scottmsilver/treddy/hardware/Esp32Tap/firmware/esp32_rs/partitions_esp32tap.csv

# Name | Type | SubType | Offset | Size | Flags
nvs | data | nvs | 0x9000 | 0x6000
phy_init | data | phy | 0xf000 | 0x1000
factory | app | factory | 0x10000 | 0x200000
storage | data | littlefs | 0x210000 | 0x100000
