scottmsilver/treddy/hardware/Esp32Tap/enclosure/esp32tap_lid.stl

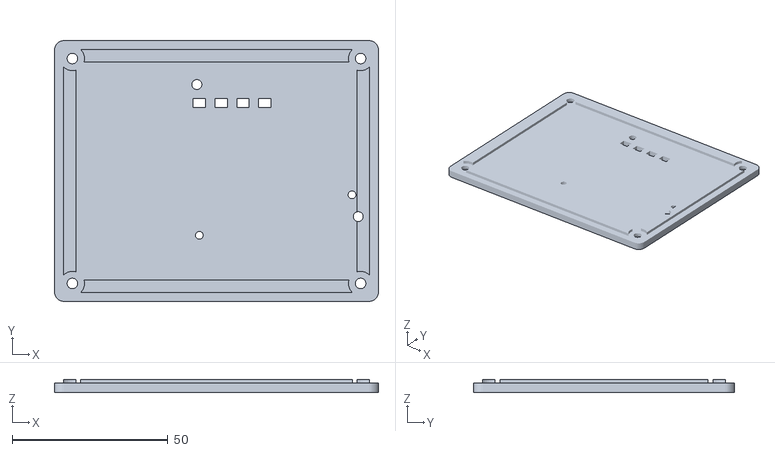
[picture p3: CAD file, 2026-11-12]
hardware/Esp32Tap/enclosure/esp32tap_lid.stl
104.0 x 83.7 x 4.20
