scottmsilver/treddy/hardware/Esp32Tap/enclosure/esp32tap_base.stl

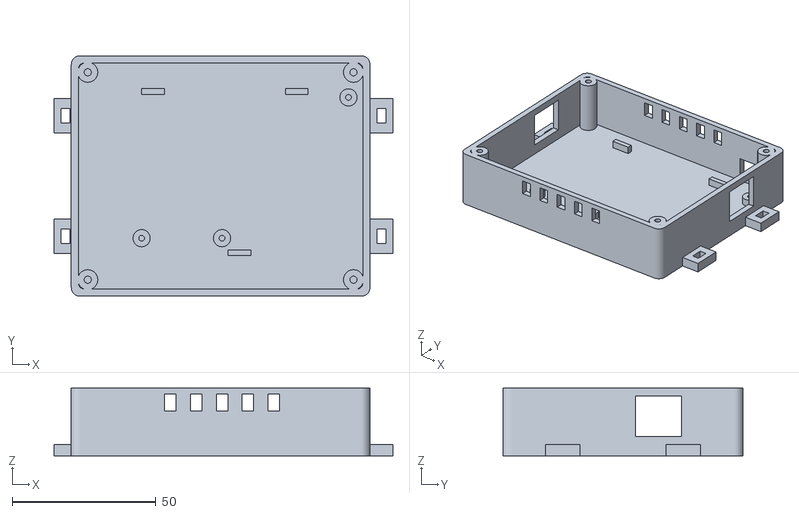
[picture p4: CAD file, 2026-11-12]
hardware/Esp32Tap/enclosure/esp32tap_base.stl
118.0 x 83.7 x 23.6
