scottmsilver/treddy/hardware/Esp32Tap/kicad/Esp32Tap.kicad_pcb

## KiCad design hardware/Esp32Tap/kicad/Esp32Tap.kicad_pcb (2026-11-12)

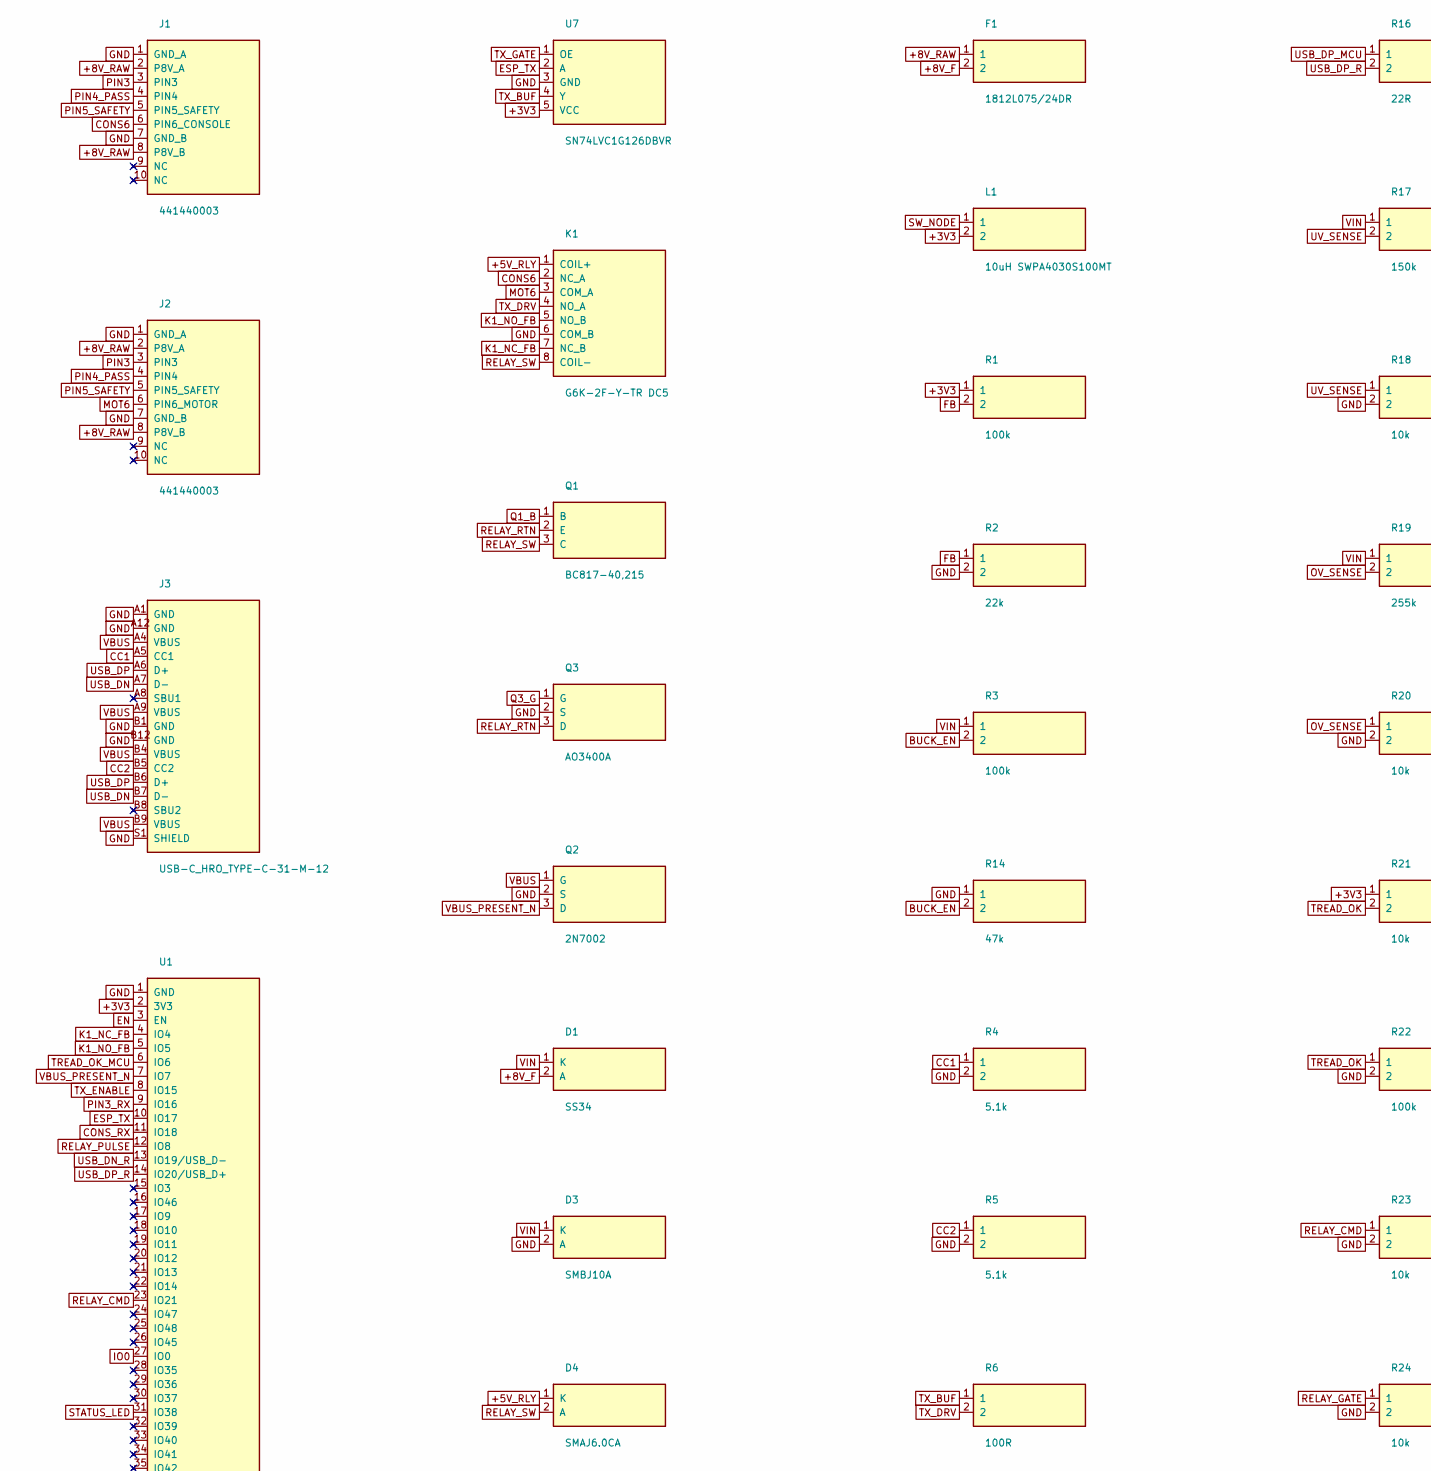
[picture p5: schematic Esp32Tap.kicad_sch, Esp32Tap Rev E - ESP32-S3 Precor serial-bus tap, part in row 1, column 1]

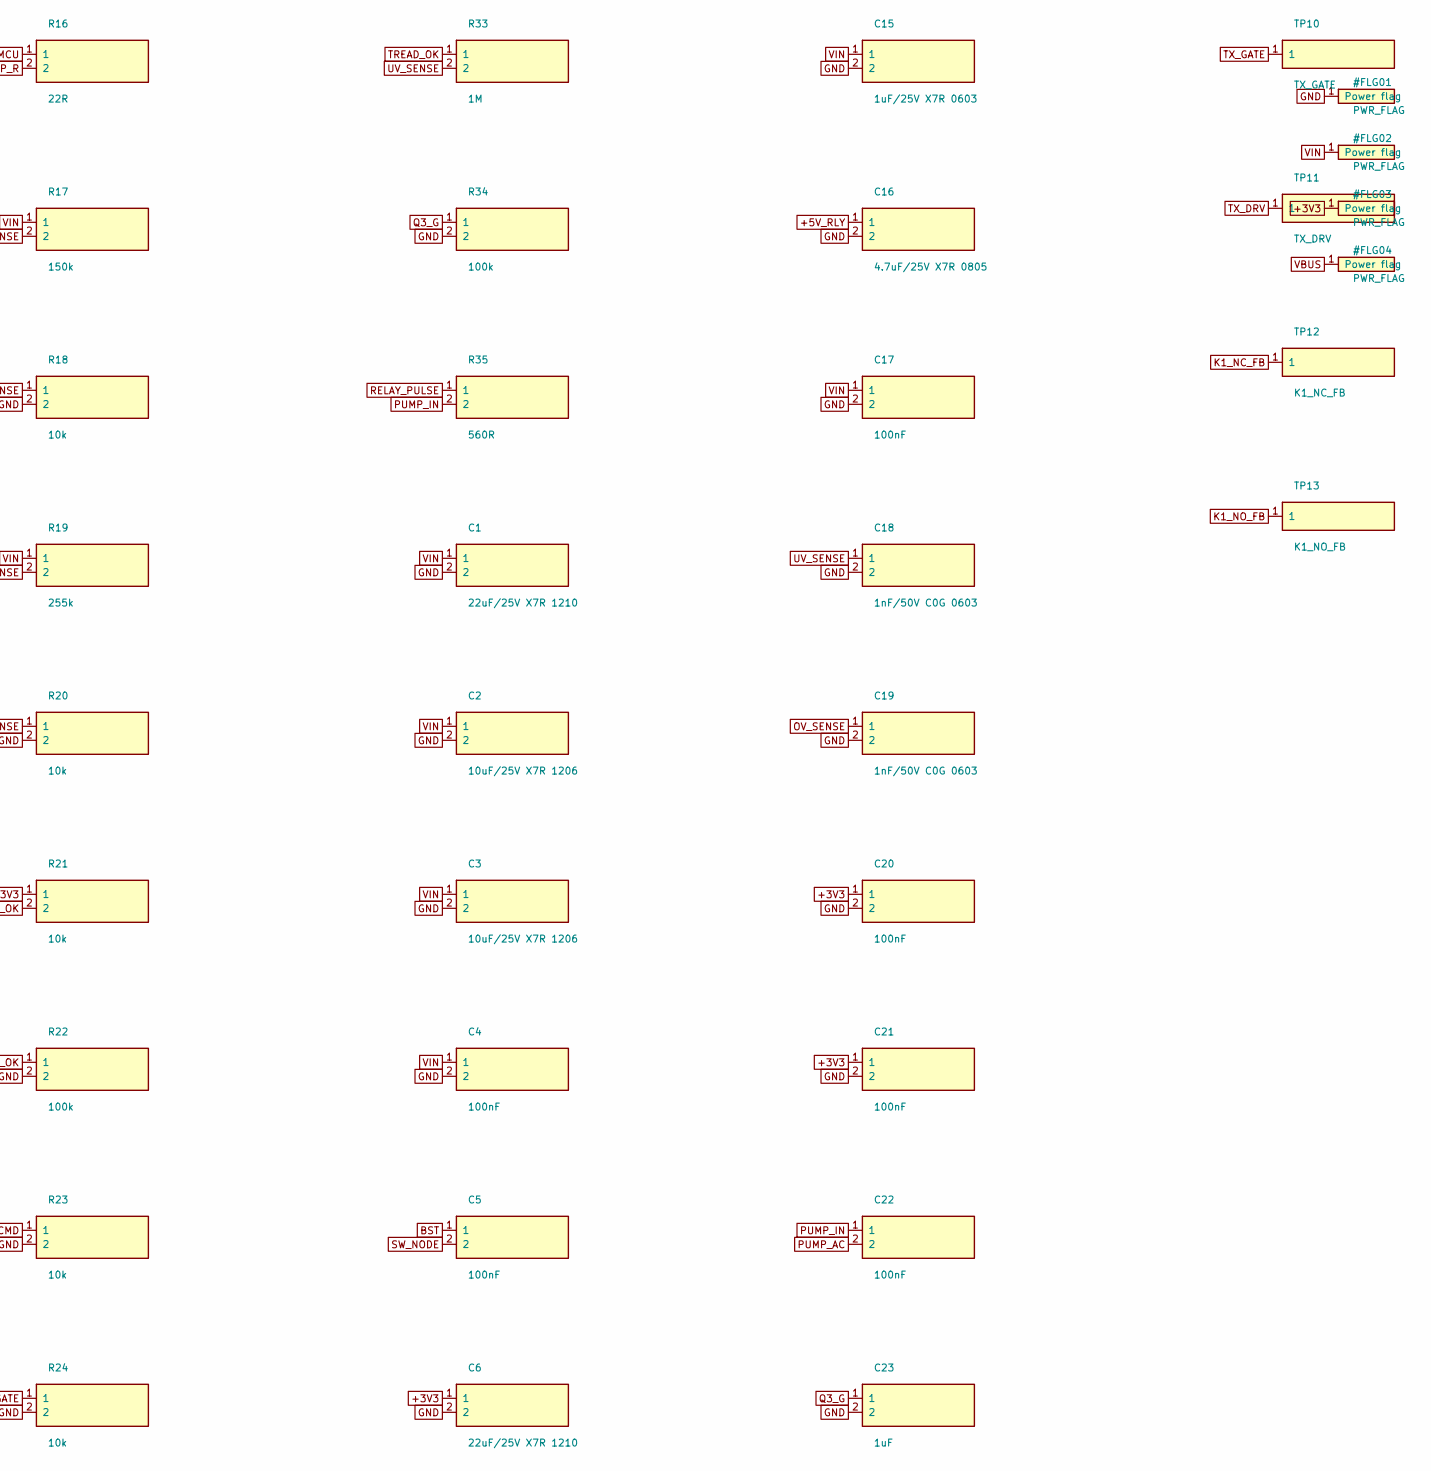
[picture p6: schematic Esp32Tap.kicad_sch, Esp32Tap Rev E - ESP32-S3 Precor serial-bus tap, part in row 1, column 2]

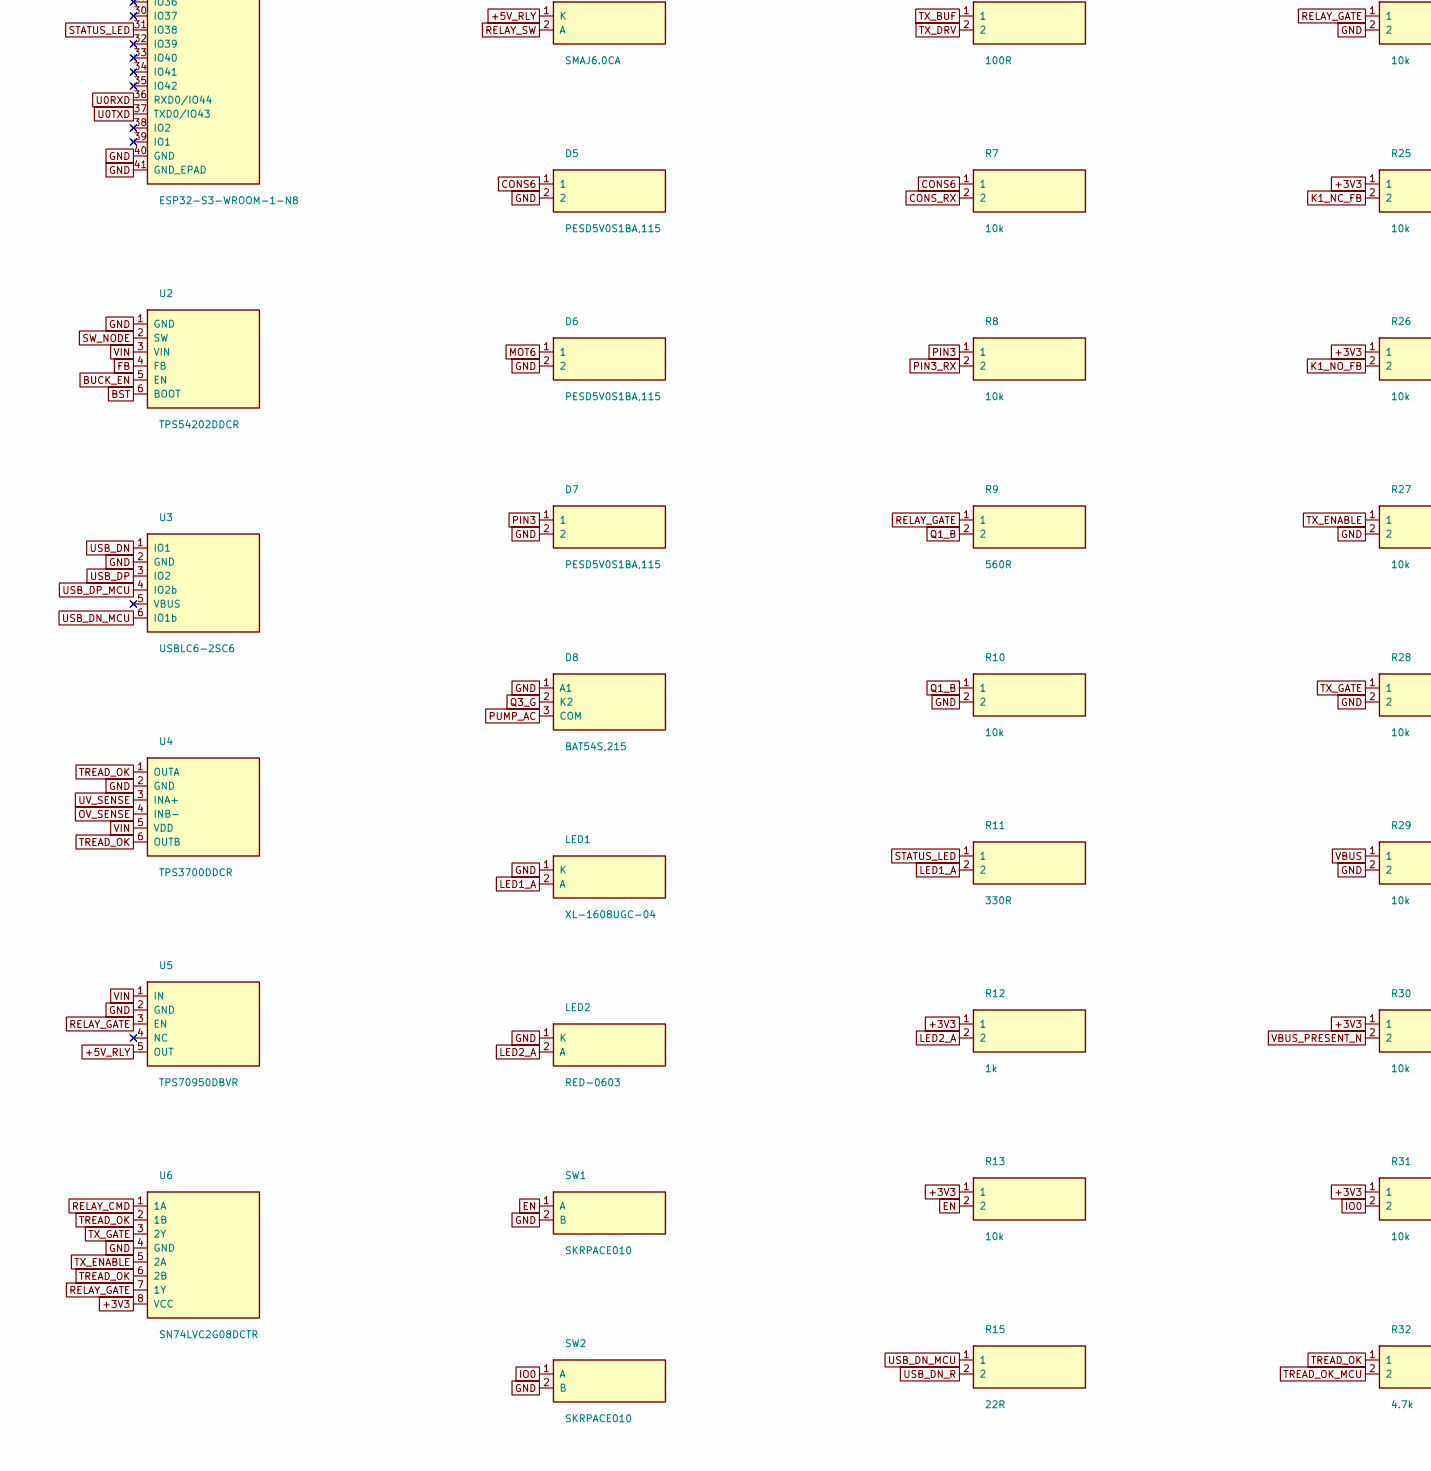
[picture p7: schematic Esp32Tap.kicad_sch, Esp32Tap Rev E - ESP32-S3 Precor serial-bus tap, part in row 2, column 1]

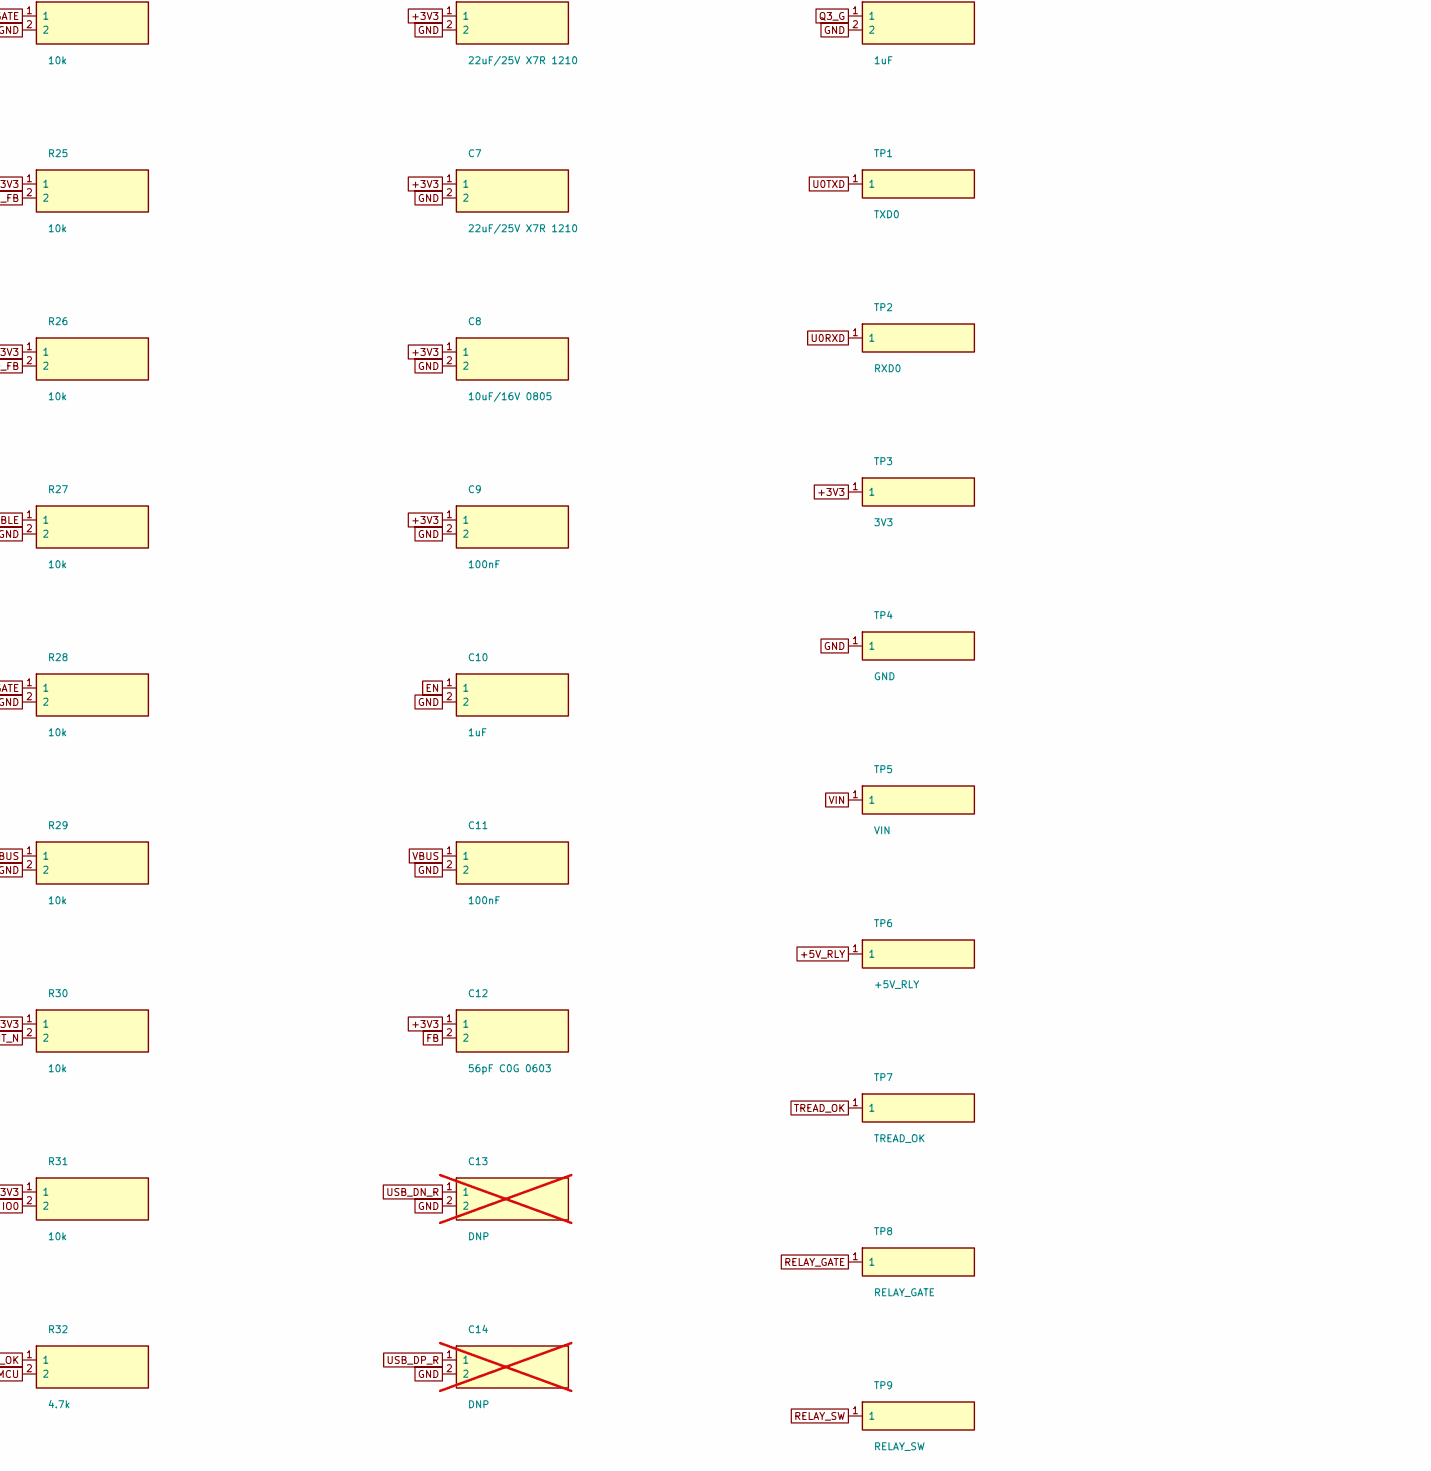
[picture p8: schematic Esp32Tap.kicad_sch, Esp32Tap Rev E - ESP32-S3 Precor serial-bus tap, part in row 2, column 2]

Parts:
C1, C6, C7: 22uF/25V X7R 1210; C_1210_3225Metric; LCSC C2918511
C2, C3: 10uF/25V X7R 1206; C_1206_3216Metric; LCSC C14860
C4, C5, C9, C11, C17, C20, C21, C22: 100nF; C_0603_1608Metric; LCSC C14663
C8: 10uF/16V 0805; C_0805_2012Metric; LCSC C15850
C10, C23: 1uF; C_0603_1608Metric; LCSC C15849
C12: 56pF C0G 0603; C_0603_1608Metric; LCSC C39148
C13, C14: DNP; C_0603_1608Metric; JLC Class DNP; not fitted
C15: 1uF/25V X7R 0603; C_0603_1608Metric; LCSC C106858
C16: 4.7uF/25V X7R 0805; C_0805_2012Metric; LCSC C354262
C18, C19: 1nF/50V C0G 0603; C_0603_1608Metric; LCSC C342541
D1: SS34; D_SMA; LCSC C8678
D3: SMBJ10A; D_SMB; LCSC C151250
D4: SMAJ6.0CA; D_SMA; LCSC C80275
D5, D6, D7: PESD5V0S1BA,115; D_SOD-323; LCSC C19224
D8: BAT54S,215; SOT-23; LCSC C47546
F1: 1812L075/24DR; Fuse_1812_4532Metric; LCSC C207065
J1, J2: 441440003; RJ45-SMD_441440003; LCSC C585890
J3: USB-C_HRO_TYPE-C-31-M-12; USB_C_Receptacle_HRO_TYPE-C-31-M-12; LCSC C165948
K1: G6K-2F-Y-TR DC5; Relay_DPDT_Omron_G6K-2F-Y; LCSC C47190
L1: 10uH SWPA4030S100MT; L_Sunlord_SWPA4030S; LCSC C38117
LED1: XL-1608UGC-04; LED_0603_1608Metric; LCSC C965804
LED2: RED-0603; LED_0603_1608Metric; LCSC C2286
Q1: BC817-40,215; SOT-23; LCSC C52801
Q2: 2N7002; SOT-23; LCSC C8545
Q3: AO3400A; SOT-23; LCSC C20917
R1, R3, R22, R34: 100k; R_0603_1608Metric; LCSC C25803
R2: 22k; R_0603_1608Metric; LCSC C31850
R4, R5: 5.1k; R_0603_1608Metric; LCSC C23186
R6: 100R; R_0603_1608Metric; LCSC C22775
R7, R8, R10, R13, R18, R20, R21, R23, R24, R25, R26, R27, R28, R29, R30, R31: 10k; R_0603_1608Metric; LCSC C25804
R9, R35: 560R; R_0603_1608Metric; LCSC C23204
R11: 330R; R_0603_1608Metric; LCSC C23138
R12: 1k; R_0603_1608Metric; LCSC C21190
R14: 47k; R_0603_1608Metric; LCSC C25819
R15, R16: 22R; R_0603_1608Metric; LCSC C23345
R17: 150k; R_0603_1608Metric; LCSC C22807
R19: 255k; R_0603_1608Metric; LCSC C23354
R32: 4.7k; R_0603_1608Metric; LCSC C23162
R33: 1M; R_0603_1608Metric; LCSC C22935
SW1, SW2: SKRPACE010; SW_SPST_SKRPACE010; LCSC C139797
TP1: TXD0; TestPoint_Pad_1.5x1.5mm; JLC Class none
TP2: RXD0; TestPoint_Pad_1.5x1.5mm; JLC Class none
TP3: 3V3; TestPoint_Pad_1.5x1.5mm; JLC Class none
TP4: GND; TestPoint_Pad_1.5x1.5mm; JLC Class none
TP5: VIN; TestPoint_Pad_1.5x1.5mm; JLC Class none
TP6: +5V_RLY; TestPoint_Pad_1.5x1.5mm; JLC Class none
TP7: TREAD_OK; TestPoint_Pad_1.5x1.5mm; JLC Class none
TP8: RELAY_GATE; TestPoint_Pad_1.5x1.5mm; JLC Class none
TP9: RELAY_SW; TestPoint_Pad_1.5x1.5mm; JLC Class none
TP10: TX_GATE; TestPoint_Pad_1.5x1.5mm; JLC Class none
TP11: TX_DRV; TestPoint_Pad_1.5x1.5mm; JLC Class none
TP12: K1_NC_FB; TestPoint_Pad_1.5x1.5mm; JLC Class none
TP13: K1_NO_FB; TestPoint_Pad_1.5x1.5mm; JLC Class none
U1: ESP32-S3-WROOM-1-N8; ESP32-S3-WROOM-1; LCSC C2913198
U2: TPS54202DDCR; SOT-23-6; LCSC C191884
U3: USBLC6-2SC6; SOT-23-6; LCSC C7519
U4: TPS3700DDCR; SOT-23-6; LCSC C33002
U5: TPS70950DBVR; SOT-23-5; LCSC C96028
U6: SN74LVC2G08DCTR; SSOP-8_2.95x2.8mm_P0.65mm; LCSC C352973
U7: SN74LVC1G126DBVR; SOT-23-5; LCSC C7834

Connections:
+3V3: C6.1, C7.1, C8.1, C9.1, C12.1, C20.1, C21.1, L1.2, R1.1, R12.1, R13.1, R21.1, R25.1, R26.1, R30.1, R31.1, TP3.1, U1.2 (3V3), U6.8 (VCC), U7.5 (VCC)
+5V_RLY: C16.1, D4.1 (K), K1.1 (COIL+), TP6.1, U5.5 (OUT)
+8V_F: D1.2 (A), F1.2
+8V_RAW: F1.1, J1.2 (P8V_A), J1.8 (P8V_B), J2.2 (P8V_A), J2.8 (P8V_B)
BST: C5.1, U2.6 (BOOT)
BUCK_EN: R3.2, R14.2, U2.5 (EN)
CC1: J3.A5 (CC1), R4.1
CC2: J3.B5 (CC2), R5.1
CONS6: D5.1, J1.6 (PIN6_CONSOLE), K1.2 (NC_A), R7.1
CONS_RX: R7.2, U1.11 (IO18)
EN: C10.1, R13.2, SW1.1 (A), U1.3 (EN)
ESP_TX: U1.10 (IO17), U7.2 (A)
FB: C12.2, R1.2, R2.1, U2.4 (FB)
GND: C1.2, C2.2, C3.2, C4.2, C6.2, C7.2, C8.2, C9.2, C10.2, C11.2, C13.2, C14.2, C15.2, C16.2, C17.2, C18.2, C19.2, C20.2, C21.2, C23.2, D3.2 (A), D5.2, D6.2, D7.2, D8.1 (A1), J1.1 (GND_A), J1.7 (GND_B), J2.1 (GND_A), J2.7 (GND_B), J3.A1 (GND), J3.A12 (GND), J3.B1 (GND), J3.B12 (GND), J3.S1 (SHIELD), K1.6 (COM_B), LED1.1 (K), LED2.1 (K), Q2.2 (S), Q3.2 (S), R2.2, R4.2, R5.2, R10.2, R14.1, R18.2, R20.2, R22.2, R23.2, R24.2, R27.2, R28.2, R29.2, R34.2, SW1.2 (B), SW2.2 (B), TP4.1, U1.1 (GND), U1.40 (GND), U1.41 (GND_EPAD), U2.1 (GND), U3.2 (GND), U4.2 (GND), U5.2 (GND), U6.4 (GND), U7.3 (GND)
IO0: R31.2, SW2.1 (A), U1.27 (IO0)
K1_NC_FB: K1.7 (NC_B), R25.2, TP12.1, U1.4 (IO4)
K1_NO_FB: K1.5 (NO_B), R26.2, TP13.1, U1.5 (IO5)
LED1_A: LED1.2 (A), R11.2
LED2_A: LED2.2 (A), R12.2
MOT6: D6.1, J2.6 (PIN6_MOTOR), K1.3 (COM_A)
OV_SENSE: C19.1, R19.2, R20.1, U4.4 (INB-)
PIN3: D7.1, J1.3 (PIN3), J2.3 (PIN3), R8.1
PIN3_RX: R8.2, U1.9 (IO16)
PIN4_PASS: J1.4 (PIN4), J2.4 (PIN4)
PIN5_SAFETY: J1.5 (PIN5_SAFETY), J2.5 (PIN5_SAFETY)
PUMP_AC: C22.2, D8.3 (COM)
PUMP_IN: C22.1, R35.2
Q1_B: Q1.1 (B), R9.2, R10.1
Q3_G: C23.1, D8.2 (K2), Q3.1 (G), R34.1
RELAY_CMD: R23.1, U1.23 (IO21), U6.1 (1A)
RELAY_GATE: R9.1, R24.1, TP8.1, U5.3 (EN), U6.7 (1Y)
RELAY_PULSE: R35.1, U1.12 (IO8)
RELAY_RTN: Q1.2 (E), Q3.3 (D)
RELAY_SW: D4.2 (A), K1.8 (COIL-), Q1.3 (C), TP9.1
STATUS_LED: R11.1, U1.31 (IO38)
SW_NODE: C5.2, L1.1, U2.2 (SW)
TREAD_OK: R21.2, R22.1, R32.1, R33.1, TP7.1, U4.1 (OUTA), U4.6 (OUTB), U6.2 (1B), U6.6 (2B)
TREAD_OK_MCU: R32.2, U1.6 (IO6)
TX_BUF: R6.1, U7.4 (Y)
TX_DRV: K1.4 (NO_A), R6.2, TP11.1
TX_ENABLE: R27.1, U1.8 (IO15), U6.5 (2A)
TX_GATE: R28.1, TP10.1, U6.3 (2Y), U7.1 (OE)
U0RXD: TP2.1, U1.36 (RXD0/IO44)
U0TXD: TP1.1, U1.37 (TXD0/IO43)
USB_DN: J3.A7 (D-), J3.B7 (D-), U3.1 (IO1)
USB_DN_MCU: R15.1, U3.6 (IO1b)
USB_DN_R: C13.1, R15.2, U1.13 (IO19/USB_D-)
USB_DP: J3.A6 (D+), J3.B6 (D+), U3.3 (IO2)
USB_DP_MCU: R16.1, U3.4 (IO2b)
USB_DP_R: C14.1, R16.2, U1.14 (IO20/USB_D+)
UV_SENSE: C18.1, R17.2, R18.1, R33.2, U4.3 (INA+)
VBUS: C11.1, J3.A4 (VBUS), J3.A9 (VBUS), J3.B4 (VBUS), J3.B9 (VBUS), Q2.1 (G), R29.1
VBUS_PRESENT_N: Q2.3 (D), R30.2, U1.7 (IO7)
VIN: C1.1, C2.1, C3.1, C4.1, C15.1, C17.1, D1.1 (K), D3.1 (K), R3.1, R17.1, R19.1, TP5.1, U2.3 (VIN), U4.5 (VDD), U5.1 (IN)

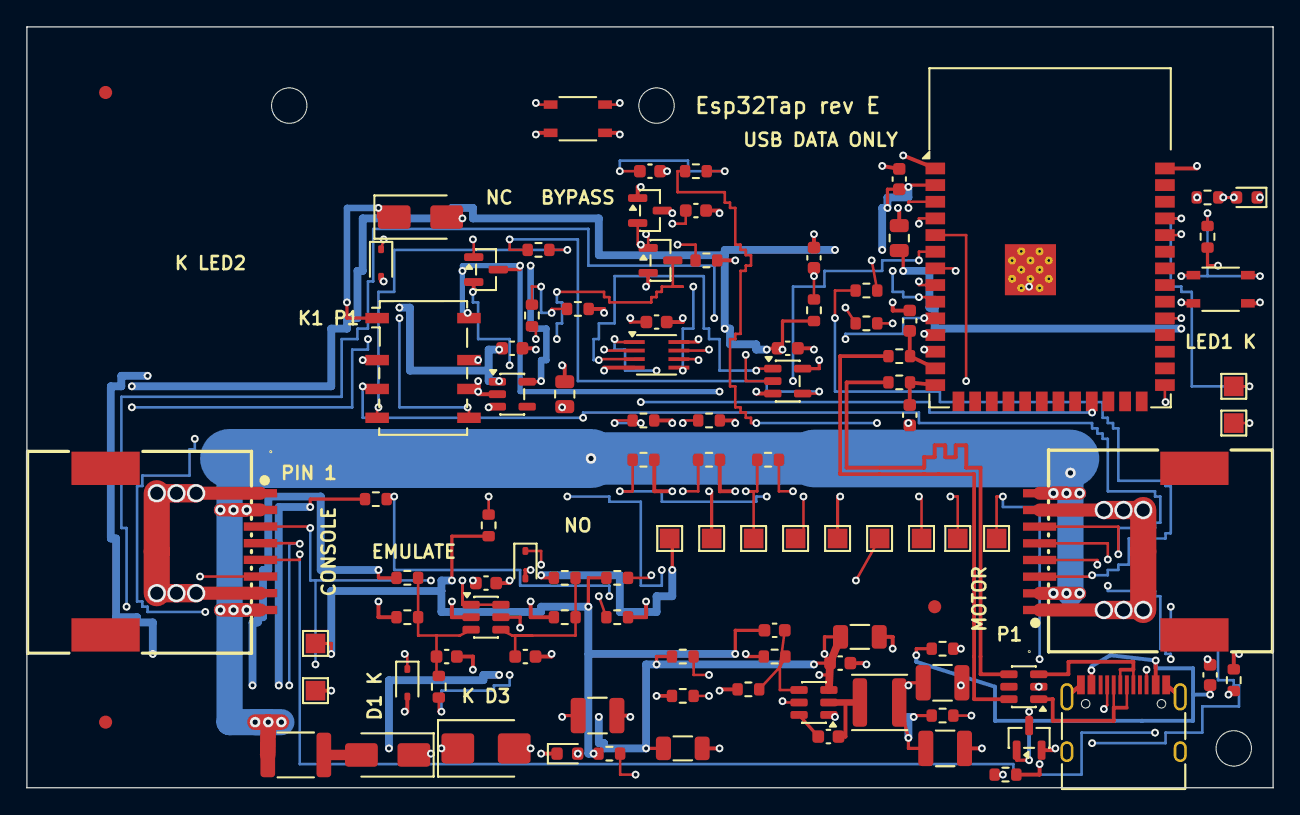
[picture p9: board Esp32Tap.kicad_pcb from above]

Board: 4 copper layers, 95.0 x 58.0 mm, 104 parts (0 on the bottom side), 54 nets.

Other parts of the board:
FID1, FID2, FID3: Fiducial; Fiducial_1mm_Mask2mm
MH1, MH2, MH3: M2.5; MountingHole_2.7mm_M2.5
