scottmsilver/treddy/python/program_engine.py

#!/usr/bin/env python3
"""
Interval training program engine with Gemini AI generation.

Manages program generation via Google Gemini API and real-time
program execution with timed speed/incline changes.
"""

import asyncio
import json
import logging
import os
import re
import time

from google import genai
from google.genai import types

log = logging.getLogger("program")

ENCOURAGEMENT_MESSAGES = [
    "Keep it up! You're doing great!",
    "Strong effort! Stay with it!",
    "Looking good! Keep pushing!",
    "You've got this! Stay strong!",
    "Nice work! Keep that pace!",
    "Crushing it! Don't stop now!",
    "Great form! Keep going!",
    "Almost there! Stay focused!",
]

MILESTONE_MESSAGES = {
    25: "Quarter of the way done — strong start!",
    50: "Halfway there! You're killing it!",
    75: "Three quarters done — the finish line is in sight!",
}

GEMINI_MODEL = "gemini-2.5-flash"
TTS_MODEL = "gemini-2.5-flash-preview-tts"


def build_tts_config(voice: str = "Kore") -> types.GenerateContentConfig:
    """Build a GenerateContentConfig for Gemini TTS. Shared by server and tests."""
    return types.GenerateContentConfig(
        responseModalities=["AUDIO"],
        speechConfig=types.SpeechConfig(
            voiceConfig=types.VoiceConfig(
                prebuiltVoiceConfig=types.PrebuiltVoiceConfig(
                    voiceName=voice,
                )
            )
        ),
    )


_client: genai.Client | None = None


def get_client() -> genai.Client:
    """Lazy singleton for the Gemini SDK client."""
    global _client
    if _client is None:
        api_key = read_api_key()
        if not api_key:
            raise ValueError("No Gemini API key. Set GEMINI_API_KEY or create .gemini_key file.")
        _client = genai.Client(api_key=api_key)
    return _client


# Application-level limits (hardware supports wider ranges)
MIN_SPEED = 0.5
MAX_SPEED = 12.0
MAX_INCLINE = 15
MIN_DURATION = 10

SYSTEM_PROMPT = """You are a treadmill interval training program designer. Generate structured workout programs as JSON.

Output a JSON object with these fields:
- "name": short motivating name (max 40 chars)
- "intervals": array of objects, each with:
  - "name": short label (e.g. "Warmup", "Sprint", "Hill Climb", "Recovery", "Cooldown")
  - "duration": seconds (integer, min 10)
  - "speed": mph (float, 0.5 to 12.0)
  - "incline": percent (0 to 15, 0.5 steps)

Rules:
- Always start with a warmup (2-5 min, low speed/incline)
- Always end with a cooldown (2-5 min, decreasing speed)
- Speed range: 0.5-12.0 mph. Incline range: 0-15
- Match the requested total duration closely
- Give intervals short, motivating names
- For walking workouts (<=4 mph), vary incline for intensity
- For running (>4 mph), vary speed and incline
- Return ONLY valid JSON"""


def read_api_key():
    key = os.environ.get("GEMINI_API_KEY")
    if key:
        return key.strip()
    for path in [".gemini_key", os.path.expanduser("~/.gemini_key")]:
        try:
            with open(path) as f:
                return f.read().strip()
        except FileNotFoundError:
            continue
    return None


def validate_interval(iv, index=None):
    """Clamp speed/incline/duration to safe ranges and ensure required fields."""
    label = f"Interval {index}" if index is not None else "Interval"
    for field in ("duration", "speed", "incline"):
        if field not in iv:
            raise ValueError(f"{label} missing '{field}'")
    try:
        iv["speed"] = round(max(MIN_SPEED, min(MAX_SPEED, float(iv["speed"]))), 1)
        iv["incline"] = max(0, min(MAX_INCLINE, round(float(iv["incline"]) * 2) / 2))
        iv["duration"] = max(MIN_DURATION, int(iv["duration"]))
    except (TypeError, ValueError) as e:
        raise ValueError(f"{label} has non-numeric value: {e}") from e
    if "name" not in iv:
        iv["name"] = f"Interval {index + 1}" if index is not None else "Added"
    return iv


class ProgramState:
    """Manages interval training program execution."""

    def __init__(self):
        self.program = None
        self.running = False
        self.paused = False
        self.completed = False
        self.current_interval = 0
        self.interval_elapsed = 0
        self.total_elapsed = 0
        self._task = None
        self._on_change = None
        self._on_update = None
        self._encouragement_milestones = set()
        self._last_encouragement_interval = -3
        self._pending_encouragement = None
        # Wall-clock timing fields
        self._clock = time.monotonic  # replaceable for testing
        self._loop_start = 0.0
        self._pause_accumulated = 0.0
        self._pause_start = 0.0
        self._interval_start_elapsed = 0

    @property
    def total_duration(self):
        if not self.program:
            return 0
        return sum(iv["duration"] for iv in self.program["intervals"])

    @property
    def current_iv(self):
        if not self.program or self.current_interval >= len(self.program["intervals"]):
            return None
        return self.program["intervals"][self.current_interval]

    def _cumulative_at(self, interval_idx):
        """Cumulative duration at start of interval."""
        if not self.program:
            return 0
        return sum(iv["duration"] for iv in self.program["intervals"][:interval_idx])

    def to_dict(self):
        d = {
            "type": "program",
            "program": self.program,
            "running": self.running,
            "paused": self.paused,
            "completed": self.completed,
            "current_interval": self.current_interval,
            "interval_elapsed": self.interval_elapsed,
            "total_elapsed": self.total_elapsed,
            "total_duration": self.total_duration,
        }
        if self._pending_encouragement:
            d["encouragement"] = self._pending_encouragement
        return d

    def drain_encouragement(self):
        """Clear pending encouragement after broadcast. Call after to_dict()."""
        self._pending_encouragement = None

    def load(self, program):
        self._cancel_task()
        self.program = program
        self.running = False
        self.paused = False
        self.completed = False
        self.current_interval = 0
        self.interval_elapsed = 0
        self.total_elapsed = 0
        self._encouragement_milestones = set()
        self._last_encouragement_interval = -3
        self._pending_encouragement = None
        self._loop_start = 0.0
        self._pause_accumulated = 0.0
        self._pause_start = 0.0
        self._interval_start_elapsed = 0

    async def start(self, on_change, on_update, *, resume_interval=0, resume_elapsed=0):
        await self.stop()
        if not self.program:
            return
        self._on_change = on_change
        self._on_update = on_update
        self.running = True
        self.paused = False
        self.completed = False
        self.current_interval = resume_interval
        self.total_elapsed = resume_elapsed
        self.interval_elapsed = resume_elapsed - self._cumulative_at(resume_interval)
        self._encouragement_milestones = set()
        self._last_encouragement_interval = -3
        self._pending_encouragement = None
        self._loop_start = self._clock() - resume_elapsed
        self._pause_accumulated = 0.0
        self._pause_start = 0.0
        self._interval_start_elapsed = self._cumulative_at(resume_interval)
        # Pre-mark milestones already passed
        if self.total_duration > 0:
            pct = (resume_elapsed / self.total_duration) * 100
            for milestone in (25, 50, 75):
                if pct >= milestone:
                    self._encouragement_milestones.add(milestone)
        iv = self.current_iv
        if iv and self._on_change:
            await self._on_change(iv["speed"], iv["incline"])
        await self._broadcast()
        self._task = asyncio.create_task(self._tick_loop())

    async def stop(self):
        self._cancel_task()
        was_running = self.running
        self.running = False
        self.paused = False
        if was_running and self._on_change:
            await self._on_change(0, 0)
        await self._broadcast()

    async def reset(self):
        """Full reset: stop, clear program and completed state."""
        self._cancel_task()
        was_running = self.running
        self.program = None
        self.running = False
        self.paused = False
        self.completed = False
        self.current_interval = 0
        self.interval_elapsed = 0
        self.total_elapsed = 0
        self._encouragement_milestones = set()
        self._last_encouragement_interval = -3
        self._pending_encouragement = None
        self._loop_start = 0.0
        self._pause_accumulated = 0.0
        self._pause_start = 0.0
        self._interval_start_elapsed = 0
        if was_running and self._on_change:
            await self._on_change(0, 0)
        await self._broadcast()

    async def toggle_pause(self):
        if not self.paused:
            # Pausing: record when pause started
            self.paused = True
            self._pause_start = self._clock()
        else:
            # Resuming: accumulate pause duration
            self.paused = False
            if self._pause_start > 0:
                self._pause_accumulated += self._clock() - self._pause_start
                self._pause_start = 0.0
            # Re-apply current interval's speed/incline
            if self.running:
                iv = self.current_iv
                if iv and self._on_change:
                    await self._on_change(iv["speed"], iv["incline"])
        await self._broadcast()

    def _effective_pause(self):
        """Total pause duration including any in-progress pause."""
        total = self._pause_accumulated
        if self.paused and self._pause_start > 0:
            total += self._clock() - self._pause_start
        return total

    async def skip(self):
        if not self.running:
            return
        self.current_interval += 1
        iv = self.current_iv
        if iv:
            target = self._cumulative_at(self.current_interval)
            self._loop_start = self._clock() - self._effective_pause() - target
            self._interval_start_elapsed = target
            self.total_elapsed = target
            self.interval_elapsed = 0
            if self._on_change:
                await self._on_change(iv["speed"], iv["incline"])
        else:
            await self._finish()
        await self._broadcast()

    async def prev(self):
        if not self.running:
            return
        if self.current_interval > 0:
            self.current_interval -= 1
        target = self._cumulative_at(self.current_interval)
        self._loop_start = self._clock() - self._effective_pause() - target
        self._interval_start_elapsed = target
        self.total_elapsed = target
        self.interval_elapsed = 0
        iv = self.current_iv
        if iv and self._on_change:
            await self._on_change(iv["speed"], iv["incline"])
        await self._broadcast()

    async def extend_current(self, seconds):
        """Add or subtract seconds from the current interval's duration."""
        if not self.running or not self.current_iv:
            return False
        iv = self.current_iv
        new_dur = iv["duration"] + seconds
        if new_dur < 10:
            new_dur = 10
        iv["duration"] = new_dur
        await self._broadcast()
        return True

    @property
    def is_manual(self):
        return bool(self.program and self.program.get("manual"))

    async def split_for_manual(self, speed, incline):
        """Split current interval in a manual program to record course changes."""
        if not self.running or not self.is_manual or not self.current_iv:
            return False
        iv = self.current_iv
        elapsed = max(1, int(self.interval_elapsed))
        remaining = iv["duration"] - elapsed
        if remaining < 1:
            return False
        # Same values — no split needed
        if abs(iv["speed"] - speed) < 0.05 and abs(iv["incline"] - incline) < 0.05:
            return False
        # Trim current interval to what's been completed
        iv["duration"] = elapsed
        # Count existing manual segments for naming
        seg_num = self.current_interval + 2
        # Insert new interval with remaining time at new settings
        new_iv = {
            "name": f"Seg {seg_num}",
            "duration": remaining,
            "speed": speed,
            "incline": incline,
        }
        self.program["intervals"].insert(self.current_interval + 1, new_iv)
        # Advance to the new interval
        self.current_interval += 1
        self.interval_elapsed = 0
        await self._broadcast()
        return True

    async def adjust_duration(self, delta_seconds):
        """Add or remove time from the manual program's last interval."""
        if not self.running or not self.is_manual or not self.program:
            return False
        intervals = self.program["intervals"]
        if not intervals:
            return False
        last = intervals[-1]
        new_dur = last["duration"] + delta_seconds
        if new_dur < 10:
            new_dur = 10
        last["duration"] = new_dur
        await self._broadcast()
        return True

    async def add_intervals(self, intervals):
        """Append intervals to the running program."""
        if not self.program:
            return False
        for iv in intervals:
            iv.setdefault("speed", 3)
            iv.setdefault("incline", 0)
            iv.setdefault("duration", 60)
            validate_interval(iv)
        self.program["intervals"].extend(intervals)
        await self._broadcast()
        return True

    async def _finish(self):
        # Don't cancel the task here — _finish() is called from within _tick_loop,
        # and cancelling our own task would raise CancelledError at the next await,
        # preventing _on_change and _broadcast from executing (which ends the session).
        # The task exits naturally via `break` after _finish() returns.
        self._task = None
        self.running = False
        self.paused = False
        self.completed = True
        if self._on_change:
            await self._on_change(0, 0)
        await self._broadcast()

    async def _broadcast(self):
        if self._on_update:
            await self._on_update(self.to_dict())
            self.drain_encouragement()

    def _cancel_task(self):
        if self._task:
            self._task.cancel()
            self._task = None

    def _check_encouragement(self):
        """Set encouragement message at milestones, every 3 intervals, or countdown."""
        if not self.program or not self.running:
            return
        td = self.total_duration
        if td <= 0:
            return

        # Milestone check (25/50/75%) — highest priority
        pct = (self.total_elapsed / td) * 100
        for milestone, msg in MILESTONE_MESSAGES.items():
            if pct >= milestone and milestone not in self._encouragement_milestones:
                self._encouragement_milestones.add(milestone)
                self._pending_encouragement = msg
                return

        # Every 3 intervals
        if (
            (self.current_interval - self._last_encouragement_interval) >= 3
            and self.interval_elapsed == 0
            and self.current_interval > 0
        ):
            self._last_encouragement_interval = self.current_interval
            import random

            self._pending_encouragement = random.choice(ENCOURAGEMENT_MESSAGES)
            return

        # Interval countdown (structured programs only)
        if self.is_manual:
            return
        iv = self.current_iv
        if not iv:
            return
        remaining = iv["duration"] - self.interval_elapsed
        is_last = self.current_interval == len(self.program["intervals"]) - 1

        # Build suffix: "til the end" or "til 6 mph and 3%" (only changed parts)
        if is_last:
            suffix = "til the end"
        else:
            next_iv = self.program["intervals"][self.current_interval + 1]
            parts = []
            if next_iv.get("speed") != iv.get("speed"):
                parts.append(f"{next_iv['speed']:g}mph")
            if next_iv.get("incline") != iv.get("incline"):
                parts.append(f"{next_iv['incline']:g}%")
            suffix = ("til " + " and ".join(parts)) if parts else "til next section"

        if remaining <= 30:
            if remaining >= 1:
                self._pending_encouragement = f"<<{remaining}>>s {suffix}"
        elif remaining <= 610:
            # Trigger 10s early so message lands right at the minute mark
            adjusted = remaining - 10
            if adjusted > 0 and adjusted % 60 == 0:
                minutes = adjusted // 60
                unit = "minute" if minutes == 1 else "minutes"
                self._pending_encouragement = f"<<{minutes}>> {unit} {suffix}"

    async def _tick_loop(self):
        try:
            while self.running:
                await asyncio.sleep(1)
                if self.paused:
                    await self._broadcast()
                    continue

                # Wall-clock elapsed (excluding paused time)
                real_elapsed = self._clock() - self._loop_start - self._pause_accumulated
                self.total_elapsed = int(real_elapsed)
                self.interval_elapsed = self.total_elapsed - self._interval_start_elapsed

                iv = self.current_iv
                if not iv:
                    await self._finish()
                    break

                if self.interval_elapsed >= iv["duration"]:
                    self.current_interval += 1
                    self._interval_start_elapsed = self.total_elapsed
                    self.interval_elapsed = 0
                    nxt = self.current_iv
                    if nxt:
                        if self._on_change:
                            await self._on_change(nxt["speed"], nxt["incline"])
                    else:
                        await self._finish()
                        break

                # Check encouragement milestones
                self._check_encouragement()

                await self._broadcast()
        except asyncio.CancelledError:
            pass


async def generate_program(prompt, api_key=None):
    """Call Gemini to generate an interval training program."""
    if not api_key:
        api_key = read_api_key()
    if not api_key:
        raise ValueError("No Gemini API key. Set GEMINI_API_KEY or create .gemini_key file.")

    contents = [{"parts": [{"text": prompt}]}]
    gen_config = {"responseMimeType": "application/json", "maxOutputTokens": 4096}
    result = await call_gemini(contents, SYSTEM_PROMPT, api_key=api_key, generation_config=gen_config)

    try:
        text = result["candidates"][0]["content"]["parts"][0]["text"]
    except (KeyError, IndexError) as e:
        log.error(f"Gemini response format error: {e}, response: {json.dumps(result)[:500]}")
        raise ValueError(f"Bad Gemini response: {e}")
    try:
        program = json.loads(text)
    except json.JSONDecodeError:
        # Try to salvage truncated JSON by finding the last complete interval
        text = text.rstrip()
        if not text.endswith("}"):
            last_brace = text.rfind("}")
            if last_brace > 0:
                text = text[: last_brace + 1] + "]}"
        program = json.loads(text)

    if "intervals" not in program or not program["intervals"]:
        raise ValueError("Program has no intervals")

    for i, iv in enumerate(program["intervals"]):
        validate_interval(iv, index=i)

    if "name" not in program:
        program["name"] = "Custom Workout"

    return program


# --- Chat / Agentic Function Calling ---

CHAT_SYSTEM_PROMPT = """You are an AI treadmill coach. You control a Precor treadmill via function calls.
Be brief, friendly, motivating. Respond in 1-3 short sentences max.
Feel free to use emoji in your responses when it feels natural.
You can wrap a single important word in <<double angle brackets>> to give it an animated glow effect in the UI. Use sparingly for emphasis.

Tools:
- set_speed: change speed (mph). Use 0 to stop belt.
- set_incline: change incline (0-15%, 0.5 steps)
- generate_workout: create an interval program from a description (does NOT start it)
- start_workout: start the currently loaded program (call after generate_workout or load_workout)
- stop_treadmill: emergency stop (speed 0, incline 0, end program)
- pause_program / resume_program: pause/resume interval programs
- skip_interval: skip to next interval
- extend_interval: add or subtract seconds from current interval (positive = longer, negative = shorter)
- add_time: add extra intervals at the end of the current program

CRITICAL RULE — never change speed, incline, or any treadmill setting unless the user explicitly asks you to. Do NOT proactively adjust settings to "push" or "challenge" the user. Only use tools in direct response to a clear user request.

Guidelines:
- For workout requests, FIRST call generate_workout to create the program, THEN describe it to the user, THEN call start_workout only after the user confirms. Never skip the confirmation step.
- For simple adjustments ("faster", "more incline"), use set_speed/set_incline
- Walking: 2-4 mph. Jogging: 4-6 mph. Running: 6+ mph
- If user says "stop", use stop_treadmill immediately
- For "more time", "extend", "add 5 minutes" etc., use extend_interval or add_time
- extend_interval changes the CURRENT interval's duration (e.g. +60 adds 1 min)
- add_time appends new intervals at the END of the program
- Always confirm what you did briefly"""

SMARTASS_ADDENDUM = """
SMART-ASS MODE: Be sarcastic, witty, and make fun of the user for being lazy.
Roast them (lovingly) about their pace, breaks, or workout choices.
Still be helpful and encouraging underneath the sass."""

TOOL_DECLARATIONS = [
    {
        "functionDeclarations": [
            {
                "name": "set_speed",
                "description": "Set treadmill belt speed",
                "parameters": {
                    "type": "OBJECT",
                    "properties": {"mph": {"type": "NUMBER", "description": "Speed in mph (0-12)"}},
                    "required": ["mph"],
                },
            },
            {
                "name": "set_incline",
                "description": "Set treadmill incline grade",
                "parameters": {
                    "type": "OBJECT",
                    "properties": {"incline": {"type": "NUMBER", "description": "Incline percent (0-15, 0.5 steps)"}},
                    "required": ["incline"],
                },
            },
            {
                "name": "generate_workout",
                "description": "Generate an interval training program from a description. Does NOT start it. Describe the result to the user and wait for confirmation before calling start_workout.",
                "parameters": {
                    "type": "OBJECT",
                    "properties": {"description": {"type": "STRING", "description": "Workout description"}},
                    "required": ["description"],
                },
            },
            {
                "name": "start_workout",
                "description": "Start the currently loaded workout program. Only call this after generate_workout or load_workout, and after the user confirms they want to start.",
                "parameters": {"type": "OBJECT", "properties": {}},
            },
            {
                "name": "stop_treadmill",
                "description": "Stop the treadmill and end any running program",
                "parameters": {"type": "OBJECT", "properties": {}},
            },
            {
                "name": "pause_program",
                "description": "Pause the running interval program",
                "parameters": {"type": "OBJECT", "properties": {}},
            },
            {
                "name": "resume_program",
                "description": "Resume a paused program",
                "parameters": {"type": "OBJECT", "properties": {}},
            },
            {
                "name": "skip_interval",
                "description": "Skip to next interval in program",
                "parameters": {"type": "OBJECT", "properties": {}},
            },
            {
                "name": "extend_interval",
                "description": "Add or subtract seconds from the current interval duration. Positive = longer, negative = shorter. Min 10s.",
                "parameters": {
                    "type": "OBJECT",
                    "properties": {
                        "seconds": {"type": "NUMBER", "description": "Seconds to add (positive) or subtract (negative)"}
                    },
                    "required": ["seconds"],
                },
            },
            {
                "name": "add_time",
                "description": "Add extra intervals at the end of the running program",
                "parameters": {
                    "type": "OBJECT",
                    "properties": {
                        "intervals": {
                            "type": "ARRAY",
                            "description": "Array of interval objects with name, duration (seconds), speed (mph), incline (%)",
                            "items": {
                                "type": "OBJECT",
                                "properties": {
                                    "name": {"type": "STRING"},
                                    "duration": {"type": "NUMBER"},
                                    "speed": {"type": "NUMBER"},
                                    "incline": {"type": "NUMBER"},
                                },
                            },
                        }
                    },
                    "required": ["intervals"],
                },
            },
            {
                "name": "load_workout",
                "description": "Load and start a saved or recent workout by its id. Present the available workouts to the user first and let them choose before calling this.",
                "parameters": {
                    "type": "OBJECT",
                    "properties": {
                        "id": {
                            "type": "STRING",
                            "description": "The workout id from the available workouts list in your context",
                        },
                        "start": {
                            "type": "BOOLEAN",
                            "description": "Whether to immediately start the workout after loading (default: true)",
                        },
                    },
                    "required": ["id"],
                },
            },
            {
                "name": "query_workout_data",
                "description": "Query the workout database using SQL. Returns workout structures, interval details, and run history. Use SELECT queries only.",
                "parameters": {
                    "type": "OBJECT",
                    "properties": {
                        "sql": {
                            "type": "STRING",
                            "description": "A SELECT SQL query against the workout database tables",
                        }
                    },
                    "required": ["sql"],
                },
            },
        ]
    }
]


async def call_gemini(contents, system_prompt, tools=None, api_key=None, generation_config=None):
    """Low-level Gemini API call with optional function calling.

    Returns a dict matching the REST API camelCase format so callers
    don't need to change.
    """
    client = get_client()

    config_kwargs = {"temperature": 0.7, "maxOutputTokens": 1024}
    if generation_config:
        config_kwargs.update(generation_config)
    config_kwargs["systemInstruction"] = system_prompt
    if tools:
        config_kwargs["tools"] = tools

    config = types.GenerateContentConfig(**config_kwargs)

    resp = await client.aio.models.generate_content(
        model=GEMINI_MODEL,
        contents=contents,
        config=config,
    )
    return resp.model_dump(by_alias=True, exclude_none=True)


# --- Voice intent extraction ---

INTENT_TOOL_SCHEMA = json.dumps(
    [
        {"name": "set_speed", "args": {"mph": "number (e.g. 3.5)"}},
        {"name": "set_incline", "args": {"incline": "number 0-15 (0.5 steps)"}},
        {"name": "generate_workout", "args": {"description": "string"}},
        {"name": "start_workout", "args": {}},
        {"name": "stop_treadmill", "args": {}},
        {"name": "pause", "args": {}},
        {"name": "resume", "args": {}},
        {"name": "skip_interval", "args": {}},
    ],
    indent=2,
)


# Map short names from intent schema to full function names expected by _exec_fn
_INTENT_NAME_MAP = {
    "pause": "pause_program",
    "resume": "resume_program",
}


async def extract_intent_from_text(text: str, already_executed: list[str] | None = None) -> list[dict]:
    """Extract intended function calls from narration text via Gemini Flash JSON mode.

    When Gemini Live narrates its intent as text instead of emitting a toolCall,
    this function recovers by asking Flash to parse the intent using JSON extraction.

    Returns [{"name": ..., "args": {...}}, ...]. Does not execute anything.
    """
    already = set(already_executed or [])

    if already:
        already_str = f"\n\nThese functions were ALREADY executed — exclude them: {', '.join(already)}"
    else:
        already_str = ""

    prompt = (
        "A voice assistant intended to control a treadmill but narrated its intent as text "
        "instead of making function calls. Extract the intended function calls from the text below.\n\n"
        f"Available functions:\n{INTENT_TOOL_SCHEMA}\n\n"
        'Return a JSON array of objects with "name" and "args" fields. '
        "Return ALL intended function calls. If no functions are intended, return an empty array []."
        f"{already_str}\n\n"
        f'Text: "{text}"'
    )
    contents = [{"role": "user", "parts": [{"text": prompt}]}]

    result = await call_gemini(
        contents,
        "You extract structured data from text. Return valid JSON only.",
        None,
        generation_config={"responseMimeType": "application/json", "temperature": 0},
    )
    parts = result.get("candidates", [{}])[0].get("content", {}).get("parts", [])
    raw_text = " ".join(p.get("text", "") for p in parts).strip()

    actions = []
    try:
        clean = raw_text.strip()
        if clean.startswith("```"):
            clean = "\n".join(clean.split("\n")[1:])
            if clean.endswith("```"):
                clean = clean[:-3]
            clean = clean.strip()
        parsed = json.loads(clean)
        if isinstance(parsed, dict) and "actions" in parsed:
            parsed = parsed["actions"]
        if not isinstance(parsed, list):
            parsed = [parsed]
        for item in parsed:
            if not isinstance(item, dict) or "name" not in item:
                continue
            name = _INTENT_NAME_MAP.get(item["name"], item["name"])
            args = item.get("args", {})
            if name in already:
                continue
            # Coerce numeric types
            if name == "set_speed" and "mph" in args:
                args["mph"] = float(args["mph"])
            if name == "set_incline" and "incline" in args:
                args["incline"] = round(float(args["incline"]) * 2) / 2
            actions.append({"name": name, "args": args})
    except json.JSONDecodeError:
        # Regex fallback for malformed JSON
        for m in re.finditer(r'"name"\s*:\s*"(\w+)"', raw_text):
            name = _INTENT_NAME_MAP.get(m.group(1), m.group(1))
            if name in already:
                continue
            region = raw_text[m.start() : m.start() + 200]
            args = {}
            if name == "set_speed":
                mph_m = re.search(r'"mph"\s*:\s*([\d.]+)', region)
                if mph_m:
                    args["mph"] = float(mph_m.group(1))
            elif name == "set_incline":
                inc_m = re.search(r'"incline"\s*:\s*([\d.]+)', region)
                if inc_m:
                    args["incline"] = round(float(inc_m.group(1)) * 2) / 2
            actions.append({"name": name, "args": args})

    return actions
