scottmsilver/treddy/python/workout_session.py

"""
WorkoutSession — owns workout session + program lifecycle.

Invariant: a program can only run within an active session.
All program starts go through start_program().

This module has NO dependencies on server.py, FastAPI, or treadmill I/O.
Callbacks (on_change, on_update) are passed in by the caller.
"""

import logging
import time

from program_engine import ProgramState

log = logging.getLogger("treadmill")


class WorkoutSession:
    """Manages workout session + program lifecycle.

    Invariant: a program can only run within an active session.
    All program starts go through start_program().
    """

    def __init__(self):
        self.prog = ProgramState()
        self.active = False
        self.started_at = 0.0
        self.wall_started_at = ""
        self.paused_at = 0.0
        self.total_paused = 0.0
        self.elapsed = 0.0
        self.distance = 0.0
        self.vert_feet = 0.0
        self.calories = 0.0
        self.last_tick = 0.0
        self.end_reason = None

    def start(self):
        """Begin session. Idempotent if already active."""
        if self.active:
            self.paused_at = 0.0
            return
        self.active = True
        self.started_at = time.monotonic()
        self.wall_started_at = time.strftime("%Y-%m-%dT%H:%M:%S")
        self.paused_at = 0.0
        self.total_paused = 0.0
        self.elapsed = 0.0
        self.distance = 0.0
        self.vert_feet = 0.0
        self.calories = 0.0
        self.last_tick = time.monotonic()
        self.end_reason = None
        log.info("Session started")

    async def start_program(self, on_change, on_update, *, resume_interval=0, resume_elapsed=0):
        """Start loaded program within a session. Ensures session active."""
        self.start()
        await self.prog.start(on_change, on_update, resume_interval=resume_interval, resume_elapsed=resume_elapsed)

    async def ensure_manual(self, speed=3.0, incline=0, duration_minutes=60, *, on_change, on_update):
        """Auto-create manual program if none running, start it."""
        if self.prog.running:
            return
        program = {
            "name": f"{duration_minutes}-Min Manual",
            "manual": True,
            "intervals": [{"name": "Seg 1", "duration": duration_minutes * 60, "speed": speed, "incline": incline}],
        }
        self.prog.load(program)
        await self.start_program(on_change, on_update)

    def end(self, reason):
        """End the current session with a reason."""
        if not self.active:
            return
        self.tick(0, 0)  # final elapsed update
        self.active = False
        self.end_reason = reason
        log.info(f"Session ended: {reason}")

    def pause(self):
        """Pause session timer."""
        if self.active and self.paused_at == 0:
            self.paused_at = time.monotonic()

    def resume(self):
        """Resume session timer."""
        if self.active and self.paused_at > 0:
            self.total_paused += time.monotonic() - self.paused_at
            self.paused_at = 0.0

    async def reset(self):
        """Full reset: stop program, zero session."""
        await self.prog.reset()
        self.active = False
        self.started_at = 0.0
        self.wall_started_at = ""
        self.paused_at = 0.0
        self.total_paused = 0.0
        self.elapsed = 0.0
        self.distance = 0.0
        self.vert_feet = 0.0
        self.calories = 0.0
        self.last_tick = 0.0
        self.end_reason = None
        log.info("Session reset")

    def tick(self, speed_mph, incline, weight_kg=70.0):
        """Compute elapsed/distance/vert/calories from monotonic clock and current speed/incline."""
        if not self.active or self.paused_at > 0:
            return
        now = time.monotonic()
        self.elapsed = max(0.0, now - self.started_at - self.total_paused)
        dt = now - self.last_tick if self.last_tick > 0 else 1.0
        self.last_tick = now
        if speed_mph > 0:
            miles_this_tick = (speed_mph / 3600) * dt
            self.distance += miles_this_tick
            if incline > 0:
                self.vert_feet += miles_this_tick * (incline / 100) * 5280
            # ACSM metabolic equation (VO2 in mL/kg/min)
            # Walking (<4.5 mph): VO2 = 3.5 + 0.1*S + 1.8*S*G
            # Running (>=4.5 mph): VO2 = 3.5 + 0.2*S + 0.9*S*G
            # where S = speed in m/min, G = fractional grade
            speed_m_min = speed_mph * 26.8224  # mph to m/min
            grade = incline / 100.0
            if speed_mph < 4.5:
                vo2 = 3.5 + 0.1 * speed_m_min + 1.8 * speed_m_min * grade
            else:
                vo2 = 3.5 + 0.2 * speed_m_min + 0.9 * speed_m_min * grade
            # kcal/min = VO2 * body_mass_kg / 1000 * 5.0
            kcal_per_min = vo2 * weight_kg / 1000.0 * 5.0
            self.calories += kcal_per_min * (dt / 60.0)

    def to_dict(self):
        """Build session state dict for WebSocket broadcast."""
        return {
            "type": "session",
            "active": self.active,
            "elapsed": self.elapsed,
            "distance": self.distance,
            "vert_feet": self.vert_feet,
            "calories": round(self.calories, 1),
            "wall_started_at": self.wall_started_at,
            "end_reason": self.end_reason,
        }
