scottmsilver/treddy/(commit log)

2026-02-19 Update README with connection details and pin info
    Removed a diagram representation of connections and updated the note about pin assignments.
2026-02-19 Add wake lock to keep screen on during workouts
    Uses the Screen Wake Lock API to prevent the device from
    dimming or locking while the UI is open. Re-acquires on
    tab focus since the browser releases it when hidden.
2026-02-21 Add BLE heart rate monitor support
    New Rust daemon (hrm/) scans for and connects to Bluetooth HR monitors,
    serving real-time BPM data over a Unix socket. Full integration with
    server.py (REST + WebSocket + Gemini context), React UI (HeartRate
    component with pulse animation, device picker in settings), and deploy
    infrastructure (systemd service, cross-compilation, Makefile targets).
    Includes code review fixes: mpsc command channel for responsive scanner,
    thread-safe state mutations, BLE address validation, STATUS_UPDATE
    reducer preserving HR fields, accessibility improvements, and DRY
    extraction of HR color zones.
    [main.rs, server.py]
2026-02-21 Fix thread safety, input validation, and UI robustness issues
    Server: wrap all background-thread callbacks (on_message, on_disconnect,
    on_reconnect, on_hrm_*) in loop.call_soon_threadsafe to prevent race
    conditions. Add Pydantic Field bounds on all user inputs (prompt length,
    audio size, speed/incline ranges). Add GPX upload size limit. Guard
    Gemini tool arg coercions against NaN/invalid values. Fix _prog_on_change
    to use MAX_SAFE_INCLINE (15) instead of MAX_INCLINE (99).
    FTMS: clamp Control Point speed to 0-12 mph and incline to 0-15% before
    forwarding to treadmill. Reset reconnect backoff after successful
    connection. Persist distance accumulator across reconnects.
    UI: extract VoiceProvid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
    [program_engine.py, server.py, treadmill_client.py, workout_session.py]
2026-02-22 Fix session timer running forever after program completes
    _finish() was not calling _broadcast(), so server.py never learned
    the program completed and the session stayed active indefinitely.
    [program_engine.py, server.py]
2026-02-23 Fix incline hex encoding and FTMS BLE compliance
    Incline on the RS-485 bus uses half-percent units in uppercase hex
    (e.g., 5% = "A", 15% = "1E"). Three bugs fixed:
    1. C++ emulation sent decimal instead of hex — motor got wrong incline
    2. Python server crashed on hex incline values (float("A"))
    3. FTMS reported 0% incline in proxy mode (only read emu_incline)
    Solution: C++ binary now decodes motor KV values and includes
    bus_speed/bus_incline in status events. All layers use this single
    source of truth. Also fixes FTMS spec compliance: correct treadmill
    data flags, feature bits, status opcodes, and adds Training Status
    characteristic.
    Hardware-verified: 0%, 5%, 10%, 15% incline all encode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
    [emulation_engine.h, server.py, test_emulation.cpp, test_ipc_protocol.cpp, test_ipc_server.cpp]
2026-02-23 Fix incline encoding: use half-percent units throughout the stack
    The incline wire protocol uses half-percent units (1=0.5%, 10=5%) but
    the C++ binary was converting to whole percent on decode, losing 0.5%
    resolution. This propagated through FTMS, Python server, and UI.
    Now half-percent units flow from wire → C++ → IPC → Python → UI:
    - C++ decode_incline_hex returns raw half-pct, encode takes half-pct
    - IPC parse_command converts float percent to half-pct (pct * 2)
    - Server stores emu_incline as half-pct, converts for display/API
    - FTMS incline range step 0.5% (was 1%), control point rounds to 0.5
    - UI buttons: single chevron ±0.5%, double ±1.0%, display 1 decimal
    - Gemini tools a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
    [server.py, test_controller_live.cpp, test_emulation.cpp, test_ipc_protocol.cpp, test_ipc_server.cpp]
2026-02-23 Fix timing drift, add local clock interpolation, and bounce encouragement
    Three related fixes for the workout experience:
    1. 59:18 bug: _tick_loop used asyncio.sleep(1) + integer counter,
    accumulating ~42s drift over 60 min. Now uses wall-clock elapsed
    via time.monotonic (replaceable _clock for testing with FakeClock).
    2. Clock stutter: Timer updated at 1Hz from server WebSocket, causing
    visible jumps. Added local 100ms interpolation in both web UI
    (useSession.ts) and Android (TreadmillViewModel). Server elapsed
    is ground truth; local clock fills gaps, clamped to server+1.5s.
    3. Encouragement bounce: Milestone messages (25/50/75%) now replace
    the timer with a spring-anim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
    [program_engine.py]
2026-02-23 Add Android app (Kotlin + Jetpack Compose)
    Native treadmill control app matching the web UI feature set:
    - Lobby, Running, Debug, Settings screens
    - WebSocket real-time state + local 100ms clock interpolation
    - Speed/incline controls with 0.5% incline steps
    - Elevation profile, metrics row, program HUD
    - Bounce encouragement animation (AnimatedContent + spring)
    - Heart rate display, HRM device picker
    - Gemini voice integration (Live API)
    - Portrait + landscape layouts, Pixel Tablet optimized
    - Quicksand body font, Recursive variable timer font
2026-02-24 YouTube controls, timer bounce fix, skip position, progress dots, code review fixes
    - Add YouTube-style player overlay (tap elevation card → Prev/Play-Pause/Next
    glass circles with dark backdrop, auto-hide 4s, persist on skip)
    - Fix timer bounce when paused (freeze local clock interpolation)
    - Fix skip/prev to jump total_elapsed to interval boundary
    - Fix skip/prev while paused clock drift (_effective_pause includes
    in-progress pause duration)
    - Add progress step indicator dots along bottom of elevation profile
    - Add autoscale Y-axis (dynamic yAxisMax based on max incline)
    - Add double-tap skip shortcut with visual feedback
    - Fix DerivedProgram.equals() missing fields (stale UI)
    - Remo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
    [TreadmillViewModel.kt, program_engine.py]
2026-02-25 Fix Android voice control: audio ordering, full-duplex, permissions, code review
    Root cause of audio crackling was concurrent coroutine processing of WebSocket
    messages on Dispatchers.IO thread pool — audio chunks enqueued out of order.
    Fixed with limitedParallelism(1) for sequential processing.
    Key changes:
    - GeminiLiveClient: sequential message processing, synchronized cleanup
    - AudioPlayer: 2s buffer, 300ms pre-buffer, batched writes, queue overflow guard
    - AudioCapture: AcousticEchoCanceler lifecycle, zombie thread prevention
    - VoiceViewModel: runtime mic permission, full-duplex (mic stays open for barge-in),
    proper resource release on disconnect, lastIncline type fix (Number→Doub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
2026-03-01 Multi-worktree isolation: Caddy, mock mode, emulator ports, Pi lock
    Each git worktree gets its own isolated dev stack with random ports
    (Caddy reverse proxy, server.py, Vite, Android emulator) so multiple
    Claude Code sessions can run simultaneously without port conflicts.
    - scripts/setup-worktree.sh: probes free ports, writes worktree.env
    - scripts/dev.sh: one-command launcher (Caddy + server + Vite)
    - scripts/worktree-env.sh: sources worktree.env or falls back to defaults
    - Caddyfile.dev: reverse proxy routing /api/*, /ws, /* to backends
    - mock_treadmill_client.py, mock_hrm_client.py: same interface as real
    clients, enables UI dev with TREADMILL_MOCK=1 (no Pi needed)
    - server.py: env-con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
    [mock_hrm_client.py, mock_treadmill_client.py, server.py]
2026-03-01 Fix FTMS Kinomap compatibility: notify+indicate CP, readable treadmill data, simpler advert
    Analyzed three Kinomap-compatible FTMS implementations (ESPHome-Treadmill-FTMS,
    bleFTMS, ESP32_TTGO) and identified three differences from our implementation:
    1. Control Point (0x2AD9): was indicate-only, now advertises both notify and
    indicate. Kinomap and other apps subscribe to notifications (CCCD 0x0100)
    rather than indications (CCCD 0x0200), so they never received our responses.
    2. Treadmill Data (0x2ACD): added read support alongside notify. Apps commonly
    read initial state before subscribing to notifications.
    3. Advertisement: removed FTMS service data bytes ([0x01, 0x01]) to match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
2026-03-01 Fix FTMS race condition: batch stop commands on single socket
    send_stop() previously opened two separate connections (speed=0, then
    incline=0), creating a window where intermediate state was visible.
    Refactored to send_commands() which batches multiple commands on one
    connection atomically.
2026-03-01 Fix FTMS stop not exiting emulate mode
    When an FTMS app sends Stop, the daemon zeroed speed/incline but left
    emulate mode active, blocking physical console buttons. Now sends
    emulate disable after zeroing so the treadmill returns to proxy mode.
2026-03-01 Fix FTMS elapsed time: clamp at u16 max, reset on belt stop
    Elapsed time silently wrapped after 18h12m due to unchecked u64→u16 cast.
    Now clamps to u16::MAX (65535s). Also resets elapsed time and distance
    when the belt stops, so the next workout starts fresh.
2026-03-01 Fix VLA stack overflow risk in serial writer
    Replaced variable-length array (up to 61KB on stack) with a fixed-size
    std::array<gpioPulse_t, 501>. KV commands are short (<50 bytes), so the
    fixed limit is generous. Oversized writes are rejected with early return.
    [serial_io.h]
2026-03-01 Restrict IPC socket permissions from 0777 to 0770
    The treadmill control socket was world-writable, allowing any user to
    send arbitrary speed/incline commands. Restrict to owner+group only.
2026-03-01 Fix ring buffer TOCTOU: return copy under lock instead of view
    at() returned a string_view into internal data without holding the lock,
    allowing torn reads if push() concurrently overwrites the slot. Now
    returns a std::string copy taken under the mutex, eliminating the race.
2026-03-01 Fix blocking socket I/O in async server functions
    All treadmill_client.set_speed/set_incline/set_emulate/set_proxy calls
    used synchronous socket.sendall(), blocking the FastAPI event loop and
    freezing all concurrent WebSocket/API clients. Added async _hw_set_*
    wrappers using asyncio.to_thread() and replaced all direct calls.
    [server.py]
2026-03-01 Fix GPX upload: check size during read, not after
    Previously read the entire file into memory before checking size,
    allowing memory exhaustion via large uploads. Now reads in 64KB chunks
    and rejects as soon as the 10MB limit is exceeded. Also checks the
    Content-Length header for fast rejection.
    [server.py]
2026-03-01 Log swallowed exceptions in treadmill_client callbacks
    on_message, on_disconnect, and on_reconnect callbacks silently swallowed
    all exceptions with bare 'except: pass', making bugs invisible. Changed
    to log.exception() so errors appear in logs while still preventing the
    reader thread from crashing.
    [treadmill_client.py]
2026-03-01 Add broadcast_status to Gemini resume_program path
    The resume_program Gemini function path didn't broadcast status after
    resuming, so WebSocket clients wouldn't see the state change until the
    next periodic update. Added broadcast_status() for consistency with
    the REST endpoint behavior.
    [server.py]
2026-03-01 Extract shared pause/resume logic into _apply_pause_toggle
    Pause logic (save speed, zero belt, update session timer) was duplicated
    between api_pause_program and _exec_fn pause_program/resume_program.
    Extracted into _apply_pause_toggle() used by all three paths.
2026-03-01 Fix runBlocking on OkHttp interceptor thread
    DynamicBaseUrlInterceptor called runBlocking on every HTTP request to
    read the server URL from DataStore, blocking the OkHttp dispatcher
    thread. Replace with a @Volatile cached field seeded once at init and
    kept current by a coroutine flow collector.
2026-03-01 Add React error boundary to prevent white-screen crashes
    Wrap the App component tree in an ErrorBoundary that catches render
    errors and shows a reload button instead of a blank white screen.
    Logs the component stack to console for debugging.
2026-03-01 Reduce unnecessary React re-renders with shallow equality checks
    The reducer created new state objects on every 1Hz WebSocket update even
    when values hadn't changed, causing all context consumers to re-render.
    Add shallowEqual checks to STATUS_UPDATE, SESSION_UPDATE, PROGRAM_UPDATE,
    CONNECTION_UPDATE, and HR_UPDATE so the reducer returns the same state
    reference when nothing changed, letting React bail out of the render.
2026-03-02 Add Mountain View experiment: planned vs actual cumulative elevation
    New MountainView component shows two lines during a workout:
    - Planned: cumulative vertical feet computed from program intervals
    - Actual: sampled from real-time session.vertFeet
    Toggle via Settings panel (persisted in localStorage). Replaces
    ElevationProfile in ProgramHUD when enabled.
2026-03-02 Serialize chat history with asyncio.Lock to prevent race conditions
    Concurrent /api/chat and /api/chat/voice requests could interleave
    mutations on the global chat_history list, causing corrupted history,
    out-of-order turns, and rollback truncating other callers' messages.
    Add _chat_lock around all chat history mutations.
    [server.py]
2026-03-02 Log exceptions from fire-and-forget auto-pause on disconnect
    The on_disconnect callback used asyncio.ensure_future() without capturing
    the task, so any exception from toggle_pause() would be silently lost.
    Now captures the task and adds a done_callback to log failures.
    [server.py]
2026-03-02 Log exceptions in broadcast_loop instead of silently swallowing
    The bare except clause was catching and discarding all errors, making
    broadcast failures invisible. Now logs the full traceback.
    [server.py]
2026-03-02 Fix ring buffer negative index UB with safe modulo
    C++ modulo preserves sign of the dividend, so at(-1) would produce
    a negative array index, crashing with .at() bounds checking. Now
    wraps negative results to valid positive indices.
    [test_ring_buffer.cpp]
2026-03-02 Prevent GeminiLiveClient disconnect/connect race condition
    When disconnect() is called, the old WebSocket's onclose handler could
    still fire and null out this.ws, destroying a newly created WebSocket
    from a subsequent connect() call. Fix by detaching all handlers from
    the old socket before calling close().
2026-03-02 Wrap validate_interval type coercion in try/except for clear errors
    Non-numeric values from Gemini (None, dicts, unparseable strings)
    would raise TypeError instead of ValueError. Now catches both and
    re-raises as ValueError with a descriptive message including the
    interval label.
    [program_engine.py]
2026-03-02 Use stable React keys on speed/incline buttons
    Dynamic keys containing emuSpeed/emuIncline caused buttons to be
    destroyed and recreated on every value change, disrupting press-and-hold
    handlers and wasting DOM operations. Pulse animations are CSS-class
    driven and don't need key-based remounting.
2026-03-02 Make TLS cert failure non-fatal in setup.sh
    With set -e, a failed tailscale cert command would abort the entire
    deploy. TLS is optional (server works without it), so now the failure
    is caught and a warning is printed instead.
2026-03-02 Fix 6 bugs from treadmill test run
    1. Auto-proxy pauses program instead of ending session (preserves timer)
    2. Pure client-side timer with exponential blend eliminates Android bounce
    3. Voice userActivated guard prevents auto-enable on interval changes
    4. Replace VoiceOverlay with pulsing mic glow on RunningScreen/TabBar
    5. Program history resume: save position on stop, offer resume on reload
    6. Fix --accent/--accent-rgb CSS vars → --green in HistoryCard
    Adds 28 new tests (timer blend, voice state guard, auto-proxy, resume).
    Documents local dev stack in CLAUDE.md.
    [TreadmillViewModel.kt]
2026-03-03 Switch timer font to Inter, self-host all fonts for offline use
    Replace Recursive with Inter for timer/numeric displays on both web and
    Android. Add raised-colon treatment (CSS translateY / Compose BaselineShift)
    for vertically centered clock colons. Self-host Inter and Quicksand fonts
    (woff2) to eliminate all external CDN dependencies — the treadmill runs
    offline. Enable cleartext HTTP in Android manifest for local network
    connections.
2026-03-03 Add interval countdown, fix layout stability, session reconnect, voice guard
    - Interval countdown takeover: server sends countdown via existing encouragement
    field. ≤30s shows "Xs till next section" every second, ≤10min shows minute
    callouts. Last interval says "till finish". Glow markup (<<>>) for purple
    highlight. Manual programs excluded, milestones take priority.
    - Fix session not ending after deploy: fetch /api/session on WebSocket reconnect
    so UI clears stale active state.
    - Fix section dots stretching: move from SVG circles (distorted by
    preserveAspectRatio=none) to HTML overlay divs.
    - Fix metrics row wiggle: tabular-nums + fixed min-width on both web and Android.
    Ext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
    [program_engine.py]
2026-03-03 Fix session timer running forever after program completes
    _finish() was calling _cancel_task() which cancelled its own running
    asyncio task. CancelledError was raised at the next await, preventing
    _broadcast() from executing — so sess.end("program_complete") never
    fired and the session timer kept counting indefinitely.
    Fix: clear self._task = None without cancelling (task exits naturally
    via break). Also fix Android countdown animation flashing by keying
    AnimatedContent on Boolean instead of the text value.
    [program_engine.py]
2026-03-03 Add persistent NavRail visible on all routes in both orientations
    Replace TabBar (which hid on the Running screen) with an orientation-aware
    NavRail: vertical left rail in landscape (icon-only, 56dp), horizontal
    bottom rail in portrait (icons + labels). Always visible on all routes.
    Remove redundant overlay home/voice buttons from RunningScreen on both
    Android and web.
2026-03-03 Responsive tablet landscape layout with proportional scaling
    Restructure RunningScreenLandscape: timer+metrics above, HUD+controls
    side-by-side below, stop button full-width at bottom. Use BoxWithConstraints
    to scale timer font, metrics text, stop buttons, and controls width
    proportionally to available screen dimensions. Add fillHeight mode to
    SpeedInclineControls for proportional button stretching in landscape.
2026-03-07 DPI-detected ergonomic touch targets (mm-based sizing)
    Replace hardcoded dp/px touch targets with human-ergonomic mm constants
    detected via real physical DPI on Android and CSS mm units on web.
    - FINGERTIP (12mm): chevron button width
    - FINGER_PAD (16mm): chevron/resume/reset button height
    - THUMB_PAD (20mm): stop button height (largest, for safety while jogging)
    Android uses displayMetrics.xdpi/ydpi for true physical sizing.
    Landscape shares BottomBar instead of duplicating button code.
    Removed 'time left' display from portrait mode.
2026-03-07 Fix timer flicker on orientation change
    Prevent Activity recreation on rotation by adding configChanges to
    AndroidManifest. Share MutableTransitionState between portrait and
    landscape so AnimatedVisibility skips enter animation when timer is
    already visible. Initialize visualActive from current session state
    instead of false.
2026-03-07 Full-screen immersive mode with symmetric timer/button edge spacing
    - Hide systemBars (not just navigationBars) for true full-screen
    - Restructure RunningScreen as 3-row layout (timer+metrics, HUD, buttons)
    - Use Paint.getTextBounds() + FirstBaseline to compute exact font glyph
    bounds, trimming timer whitespace so top gap matches bottom padding
    - Add externalPadding param to BottomBar for caller-managed spacing
    - Extract EdgePad constant shared by portrait and landscape
2026-03-08 BLE pairing agent + Kinomap alive signal for FTMS daemon
    Add auto-accept pairing agent so iOS devices can pair without repeated
    dialogs. When treadmill is idle, substitute minimum speed (0.50 km/h)
    and session elapsed time so apps like Kinomap that read speed passively
    don't reject the connection. Includes 6 unit tests and 2 integration
    tests covering the Kinomap iOS incline-only flow.
2026-03-09 Saved Workouts feature: save favorites from history, load/rename/delete
    Backend: 5 REST endpoints with Pydantic validation, collision-resistant
    nanosecond IDs, source inference (generated/gpx/manual), history cross-
    reference for saved flag. Web UI: WorkoutCard + WorkoutList components,
    heart save icon on HistoryCard, bidirectional refresh between sections,
    semantic buttons with ARIA labels, stale-fetch protection. Android: full
    parity with WorkoutList, HistoryList save callback, bidirectional refresh.
    Tests: 18 tests covering all endpoints, source inference, validation
    errors, edge cases.
    [server.py]
2026-03-09 Code review fixes: fingerprint-based saved matching, validation, atomic writes
    - Replace fragile name-based saved flag with interval fingerprint matching
    - Add program dict validation on save endpoint
    - Atomic file writes for history and workouts (tmp + os.replace)
    - Fix max cap to keep newest entries (workouts[-100:])
    - Guard Android save button when already saved
    - Delete confirmation dialog in WorkoutCard
    - Stale-fetch guard on HistoryList handleSave refetch
    - Fix intervals singular/plural in both web and Android
    - Add key() wrappers for stable Compose recomposition
    - Toast on Android data fetch errors
    - Add role/tabIndex to clickable divs for accessibility
    - Add total_duration to SavedWo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
    [server.py]
2026-03-09 Replace spline interpolation with staircase-ramp elevation profile
    Elevation profile now uses flat segments per interval with short linear
    ramps at transitions instead of Fritsch-Carlson monotone cubic splines.
    The ramps represent realistic incline change time (capped at 40% of
    the shorter neighboring interval). Both web and Android updated.
    [TreadmillViewModel.kt]
2026-03-09 Fix elevation ramp: incline holds flat to boundary, then slopes into next
    The ramp was straddling the interval boundary (starting before, ending
    after). Now the flat segment holds the current incline all the way to
    the boundary, then the ramp slopes into the next interval over a short
    distance (capped at 30% of the next interval width).
    [TreadmillViewModel.kt]
2026-03-11 Reorganize repo by language: cpp/, python/, rust/, web/, kotlin/
    Top-level directories now group by language instead of role:
    - src/ → cpp/ (with internal subdirs: protocol/, gpio/, engine/, ipc/)
    - server.py, program_engine.py, etc. → python/
    - tests/ → python/tests/
    - dual_monitor.py, listen.py → python/tools/
    - ftms/ → rust/ftms/, hrm/ → rust/hrm/
    - ui/ → web/
    - android/ → kotlin/
    All include paths, Makefiles, deploy scripts, service templates,
    documentation, and config files updated. Fix server.py static file
    and TLS cert paths to use CWD-relative instead of __file__-relative
    (needed after moving to python/server.py).
    Verified: 126 C++ tests pass, 181 Python tests pass,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
    [try3.csv, try7.csv]
2026-03-11 Fix encouragement timing: trigger minute callouts 10s early
    Minute countdown messages ("4 minutes til 6mph and 3%") now fire when
    remaining-10 is a multiple of 60, so the message appears 10 seconds
    before the rounded minute rather than exactly on it (which felt late
    during a run). Upper bound bumped 600→610 to still show "10 minutes".
    Second-by-second countdown (≤30s) unchanged.
    [program_engine.py]
2026-03-11 Fix layout jitter when encouragement swaps with timer on Running screen
    Web: use fixed 96px height on timer container instead of 'auto' so
    AnimatePresence crossfade doesn't resize the parent.
    Android: snap() SizeTransform so AnimatedContent size change is instant
    rather than animated (both portrait and landscape).
    Also adds __showBounce debug hook for testing encouragement in browser.
2026-03-11 Run history: persist run records, join last-run into program/workout cards
    - Add run_history.json persistence (max 200 records, fingerprint-joined)
    - Server computes last_run_text and usage_text — UIs just render strings
    - Remove duplicated relativeTime/lastRunText from web and Android
    - Add GET /api/runs endpoint
    - Add kotlin/.gradle/ to .gitignore
2026-03-26 Upgrade Gemini Live to 3.1 Flash Live with 2.5 fallback support
    Switch default model from gemini-2.5-flash-native-audio-latest to
    gemini-3.1-flash-live-preview. Both versions supported via model string
    check (exact match). Key 3.1 protocol changes: thinkingLevel replaces
    thinkingBudget, realtimeInput.text replaces client_content for mid-session
    text, realtimeInput.audio replaces deprecated mediaChunks for audio.
    Kotlin app stays on v1alpha/Constrained endpoint (ephemeral tokens
    require it — v1beta rejects them). Python test harness uses v1beta
    with raw API key.
    Verified: 4/4 text-prompt tool calls on emulator, 4/4 TTS audio voice
    tests pass, 110 server integration tests pass, Kotlin buil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
    [server.py]
2026-03-28 Calorie tracking: user weight profile, session calories, display in web + Kotlin
    Add user profile (weight_lbs) with /api/user GET/PUT endpoints. Session tick()
    now computes calories using ACSM running metabolic equation. Calories displayed
    in MetricsRow on both web and Kotlin running screens. Weight configurable via
    settings panel. Gemini load_workout tool added for voice-activated workout
    selection from saved workouts and history. Server-side tool declarations served
    via /api/config so all platforms get new tools automatically. Fix Python 3.11
    f-string backslash compat for Pi deployment.
    [TreadmillViewModel.kt, server.py]
2026-03-28 DMA handle guard: RAII crash recovery for pigpio GPU memory leaks
    After 11K crash-restart cycles, pigpio leaked all 512 GPU DMA handles via the
    VideoCore mailbox, preventing reinitialization. Root cause: GPU firmware has no
    concept of Linux process death, so handles allocated by a crashed process are
    never freed.
    New classes:
    - DmaGuard: probes/frees GPU mailbox handles, persists crash journal to
    /run/treadmill-io.dma-handles (tmpfs, survives crash but not reboot)
    - GpioSession: RAII wrapper that recovers leaked handles on startup, snapshots
    new allocations, and cleans up on normal shutdown via destructor
    On crash (SIGKILL/segfault), the state file persists. Next startup reads it and
    f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
    [test_dma_guard.cpp, treadmill_io.cpp]
2026-03-28 Document DMA crash recovery in CLAUDE.md
    Add DmaGuard/GpioSession documentation to the treadmill_io section explaining
    the GPU mailbox handle leak problem, the crash journal mechanism, and how
    recovery works. Update test count to 132.
2026-03-28 Update cpp/README.md with DMA crash recovery docs
    Add DMA Crash Recovery section explaining the GPU mailbox handle leak problem,
    the GpioSession/DmaGuard solution, and the startup/shutdown/crash sequences.
    Update module table and test table to include new files.
2026-03-28 Gemini workout query interface: SQL access to workout structure and run history
    Give the AI coach a read-only SQLite query interface (query_workout_data tool)
    so it can understand workout structure, reference past runs, and give contextual
    encouragement like "this is the peak interval" or "you're faster than last time."
    New: python/workout_db.py — in-memory SQLite DB populated from JSON files + live
    active program. Engine-level read-only enforcement via set_authorizer(). 500ms
    query timeout. 50-row limit.
    New: /api/tool — generic tool execution endpoint. Voice function bridges (web +
    Kotlin) fall back to it for any unknown tool, so new Gemini tools work on all
    platforms without client-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
2026-03-29 README redesign: voice-first feature showcase with tablet screenshots
    Rewrite README to lead with narrative hook and feature cards instead of
    hardware protocol details. Screenshots from the real Android tablet in
    landscape show the running screen and lobby with saved workouts.
    - Move all reverse engineering content (pinouts, protocol, hex tables) to HARDWARE.md
    - Feature cards: voice + AI coach, Android/web apps, FTMS Bluetooth, heart rate
    - Architecture diagram updated with all 4 services
    - Quick Start condensed, API/testing reference points to CLAUDE.md
    - Fix button sizing at narrow viewports (clamp instead of fixed mm)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
2026-03-29 README: strip AI slop — no emoji headers, tighter copy
2026-04-02 iOS app + voice state colors + weight vest + audio latency
    iOS app (24 Swift files, 3600+ lines):
    - Full SwiftUI app with AppShell, Lobby, Running, Settings, Debug screens
    - Gemini Live voice stack: GeminiLiveClient, AudioCapture, AudioPlayer,
    FunctionBridge, VoiceCoordinator
    - Optimistic speed/incline with dirty guard pattern
    - HRM device management, smart-ass toggle, debug unlock
    - Postel's Law: every Codable model uses custom init(from:) with defaults
    - 36 unit tests (model decoding, API contract, store behavior)
    - 13 UI tests (shell, navigation, settings, quick start, running)
    - TLS trust for Tailscale certs, shared TrustAllDelegate
    - xcodegen project.yml for reproducible builds
    Andro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
2026-04-05 Multi-user profiles: SQLite backend, profile picker, guest mode
    Replace four flat JSON files with single SQLite database (treadmill.db).
    Profiles are local named data buckets — no auth, no passwords, like a
    gaming console. Guest runs are recorded and transferable on profile creation.
    Backend:
    - python/db.py: TreadmillDB class with two connections (read/write WAL mode)
    - Profile CRUD, guest mode, avatar upload, data isolation between profiles
    - Migration from JSON files (idempotent, handles corrupted data)
    - Profile-scoped: runs, workouts, history, AI chat (raw Gemini JSON blobs)
    - 409 on profile switch during active session
    - Adversarial-tested: cross-profile access blocked, input validat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
    [LenientSerializers.kt]
2026-04-05 iPad app redesign: match Android tablet layout with iOS-native glass UI
    Redesign the iOS Treddy app from phone-first to tablet-first layout matching
    the proven Android tablet design. Orientation-aware shell with left nav rail
    in landscape, bottom tabs in portrait. iOS 26 liquid glass effects throughout.
    Features:
    - Setup screen for first-launch server URL entry
    - Multi-user profiles: picker, guest mode, profile-scoped data
    - Running view: proportional timer, elevation profile with HUD overlay,
    speed/incline controls with hold-to-repeat, double-tap skip
    - Completion view with workout stats
    - Duration editing for manual workouts (tap timer to reveal)
    - Profile switching stops active session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
2026-04-05 iOS voice control: VoiceProcessingIO AEC, UX parity with Android
    Voice:
    - Replace AVAudioEngine mic capture with raw kAudioUnitSubType_VoiceProcessingIO
    AudioUnit for hardware echo cancellation (same as FaceTime)
    - Separate AVAudioEngine for playback, AudioUnit for mic — AEC works across both
    - Move heavy AudioUnit init into warmUp() off main thread for instant voice start
    - Background Gemini connection on WS connect (no cold start on voice tap)
    - Add /api/device-log endpoint + RemoteLogger for iPad debugging without Xcode
    UI:
    - Stop button now pauses (matching Android), shows Resume + Reset when paused
    - Reset calls stopProgram before reset to preserve run records
    - Remove dead-end idl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
    [server.py]
2026-11-12 hardware(Esp32Tap): Rev E design review fixes and JLCPCB order package
    A design review (eight lenses plus an independent Codex read) found the
    Rev E board would not have left reset as drawn, and that the committed
    "0 violations" DRC report did not hold under the installed KiCad.
    Defects fixed
    * SW1/SW2 (Alps SKRPACE010) pads were numbered by column; the switch joins
    its terminals by row, so EN and IO0 were shorted to GND through the
    switch body. Pads are now numbered by row, with a regression test.
    * The PCB generator loaded stock footprints from the system KiCad library.
    KiCad 10.0.5 renamed the USB-C shell pads and regeneration crashed. Every
    stock footprint is now pinned under to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
2026-11-12 firmware(Esp32Tap): RELAY_PULSE liveness pulses, co-simulated against the circuit
    Rev E put Q3 in series with the K1 relay driver; it conducts only while IO8
    toggles at 1 kHz. This adds the firmware side and joins it to the SPICE model.
    Firmware
    - safety_core::liveness::PulseBudget: a 500 us esp_timer emits an edge only
    under a permission the supervised serial engine renews every 5 ms pass. A
    permission is bounded twice: 20 ms by the clock and 44 edges.
    - Pulses are off in Proxy and cancelled wherever outputs are applied when the
    controller is forced back to Proxy.
    - Entry waits for 60 unbroken edges (30 ms) before the relay is commanded,
    because the controller gives the relay 10 ms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
2026-11-12 hardware(Esp32Tap): JLC placement fixes, quote tool, and a wider simulation campaign
    JLCPCB placement file (found in JLC's own preview, fixed at the source)
    - Coordinates were measured from the board corner while the Gerbers use
    KiCad's absolute origin, so JLC drew every part off the board. Placements
    are now in Gerber coordinates (design.jlc_cpl_placement).
    - JLC's models for 11 parts are turned 90 or 180 degrees from KiCad's zero
    (K1, U2-U7, Q1-Q3, D8). design.JLC_ROTATION_OFFSET_DEG carries a per-part
    correction, keyed by LCSC number.
    - gen_docs, validate_artifacts and export_fab use the same convention; the
    fab audit still rejects injected position and rotation errors.
    Tools
    -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
2026-11-12 hardware(Esp32Tap): guarded save-to-cart mode for the JLC quote tool
    jlc_quote.py quote --save-to-cart --max-total USD saves the order to the
    account's cart for the owner to review and pay. It refuses unless JLC raised
    no warning, every part is confirmed, the total is at or under the limit and
    jlc_rotation_check.py passes on the preview just captured. It never checks
    out or pays; the default quote path is unchanged and still cannot touch the
    cart.
    Also waits for the order page to go idle before advancing, which a run
    showed NEXT silently ignores otherwise.
    Codex review found two gaps, both fixed and tested: charges were not
    re-judged after the final price re-read, and a non-finite --max-to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
